adammotyl22-creator/STPPE-Reborn/pcb-layout-concept/perfboard-cutting-plan.png

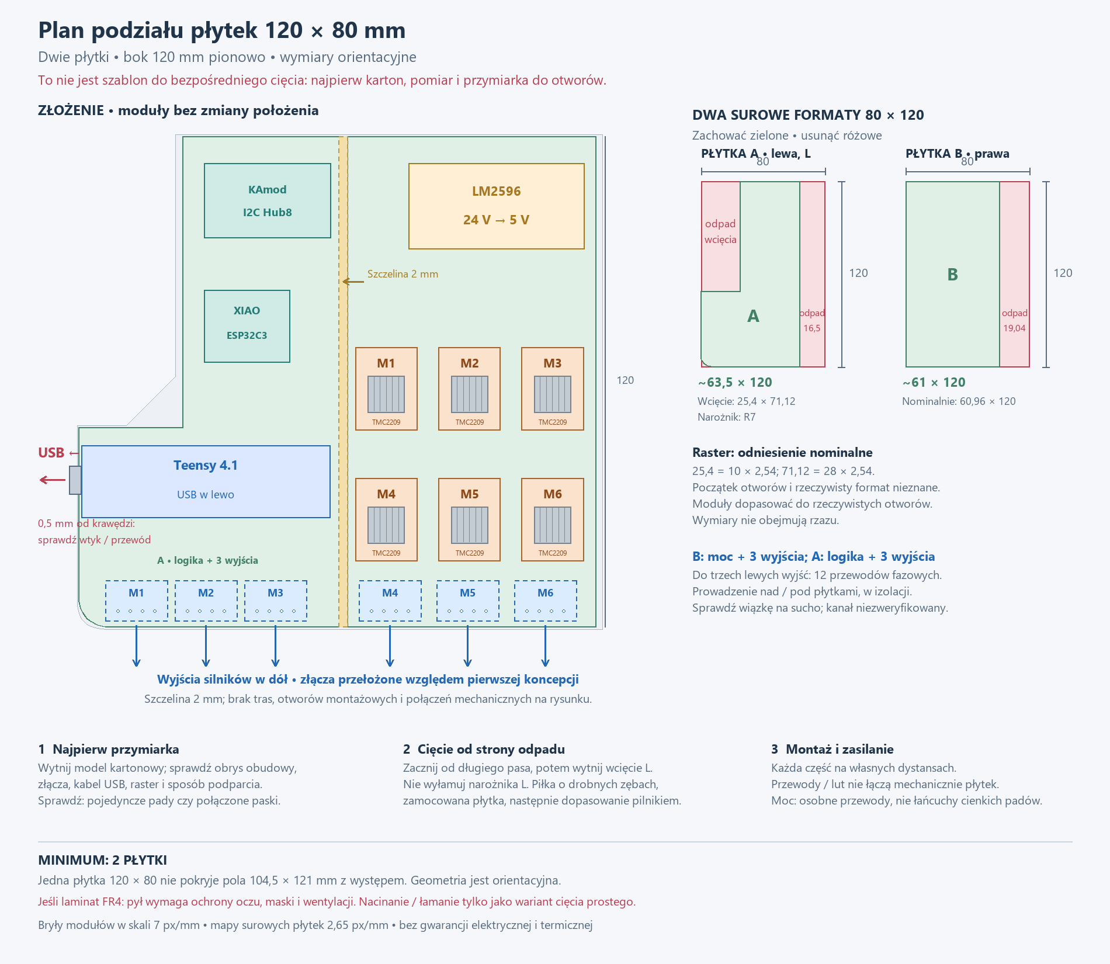
pcb-layout-concept/perfboard-cutting-plan.png
