adammotyl22-creator/STPPE-Reborn/pcb-layout-concept/robot-pcb-layout.png

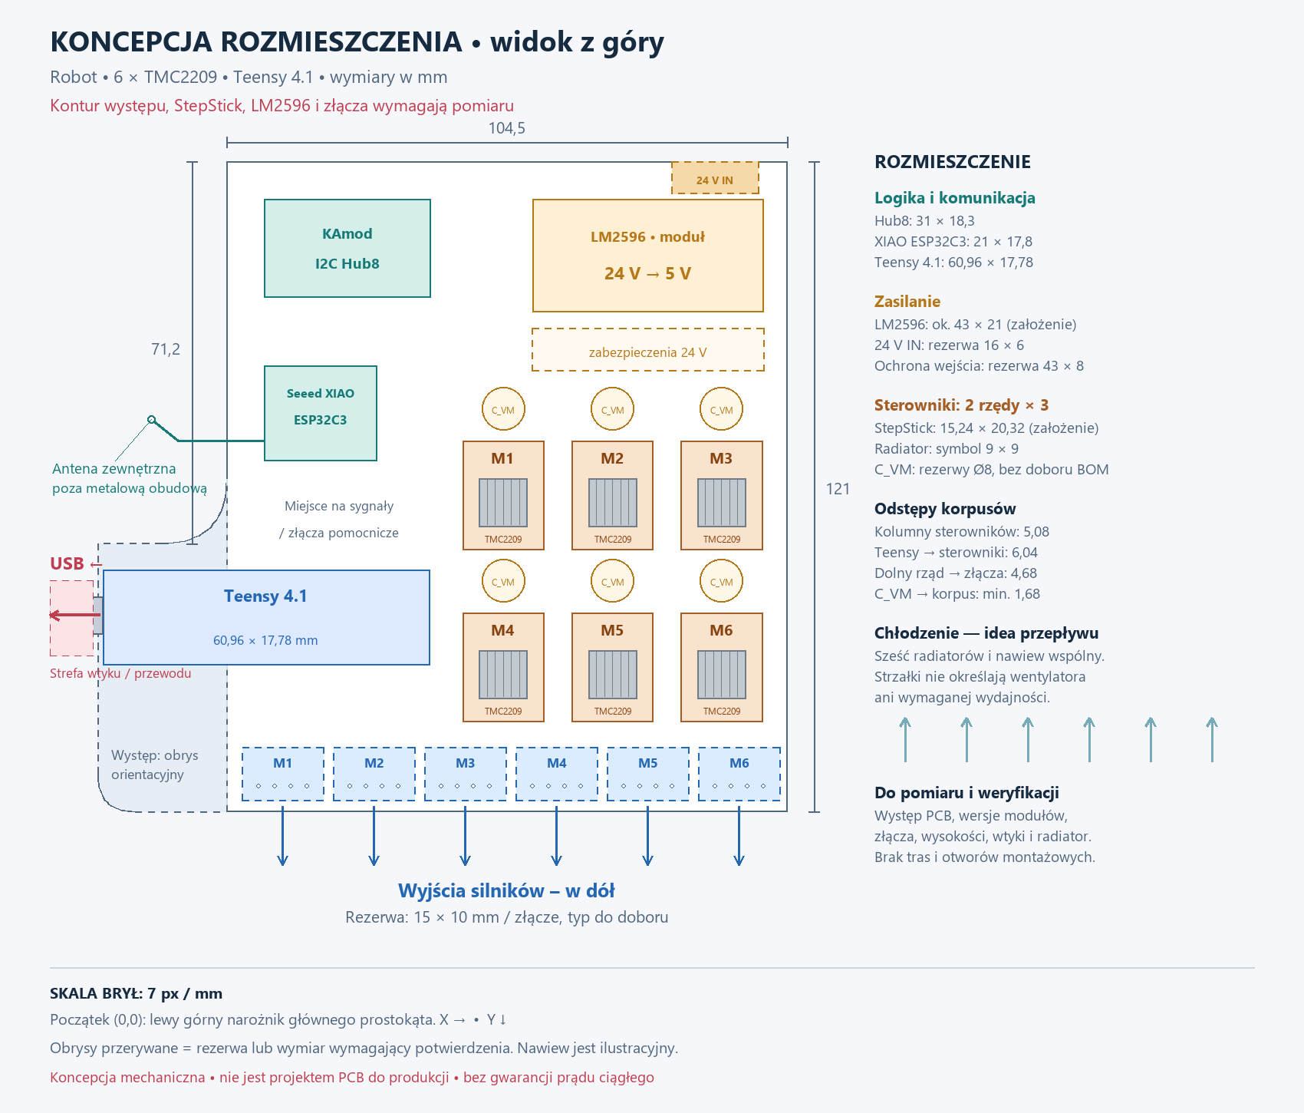
pcb-layout-concept/robot-pcb-layout.png
