adammotyl22-creator/STPPE-Reborn/WebControl/meshes/link_3.stl

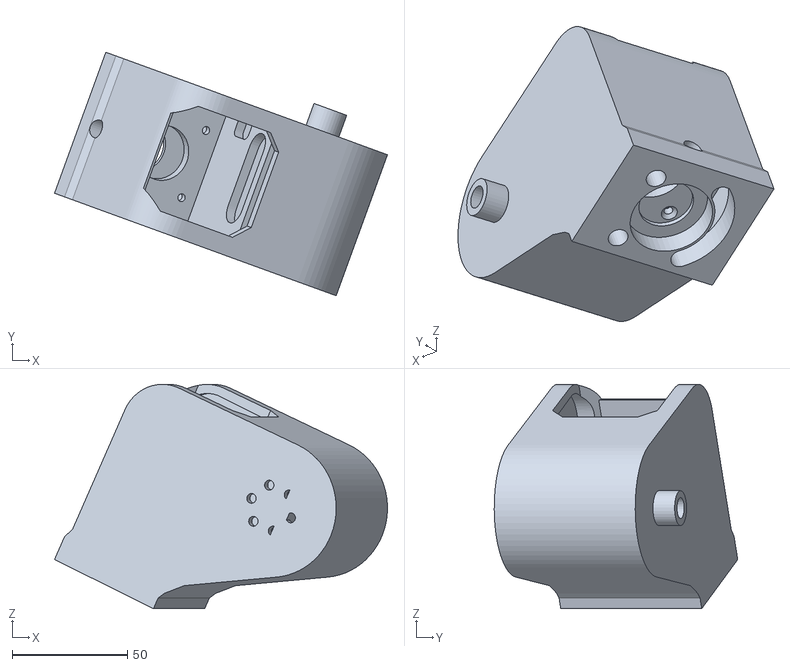
[picture p5: CAD file, 2026-10-12]
WebControl/meshes/link_3.stl
144.3 x 105.5 x 97.1
