adammotyl22-creator/STPPE-Reborn/WebControl/meshes/link_2.stl

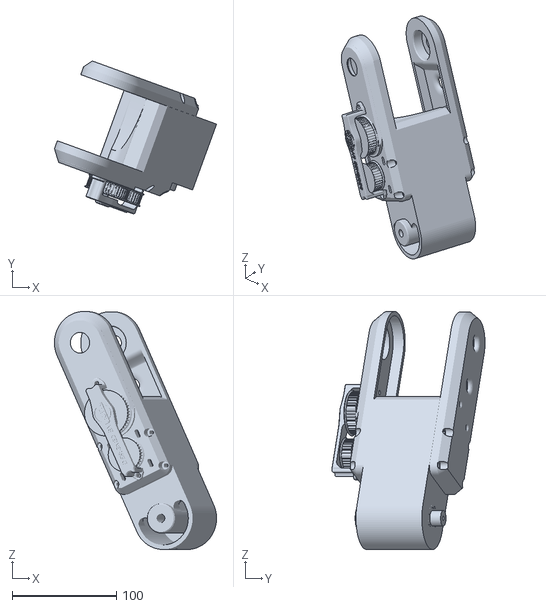
[picture p6: CAD file, 2026-10-12]
WebControl/meshes/link_2.stl
155.7 x 147.0 x 228.6
