adammotyl22-creator/STPPE-Reborn/WebControl/meshes/link_4.stl

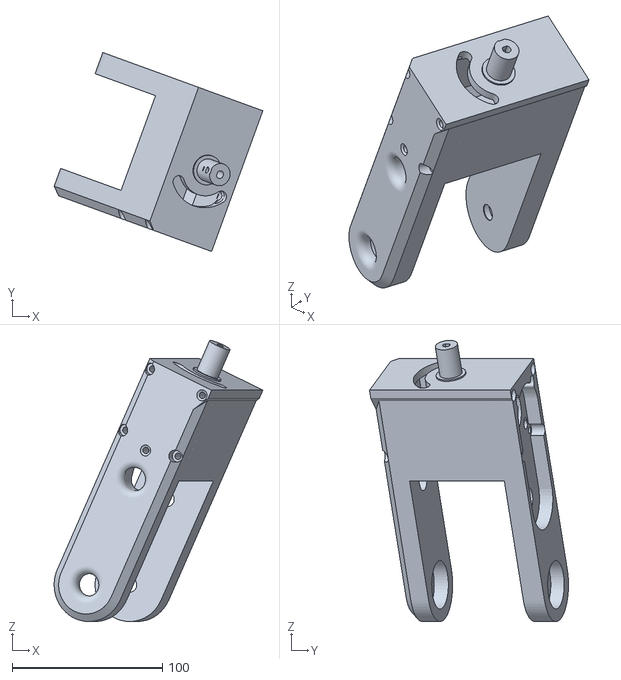
[picture p7: CAD file, 2026-10-12]
WebControl/meshes/link_4.stl
139.1 x 132.6 x 187.3
