adammotyl22-creator/STPPE-Reborn/WebControl/meshes/base_link.stl

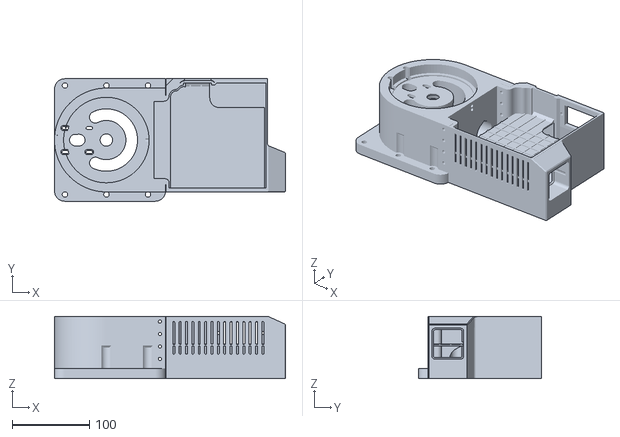
[picture p8: CAD file, 2026-10-12]
WebControl/meshes/base_link.stl
298.1 x 158.1 x 80.4
