adammotyl22-creator/STPPE-Reborn/WebControl/meshes/link_5.stl

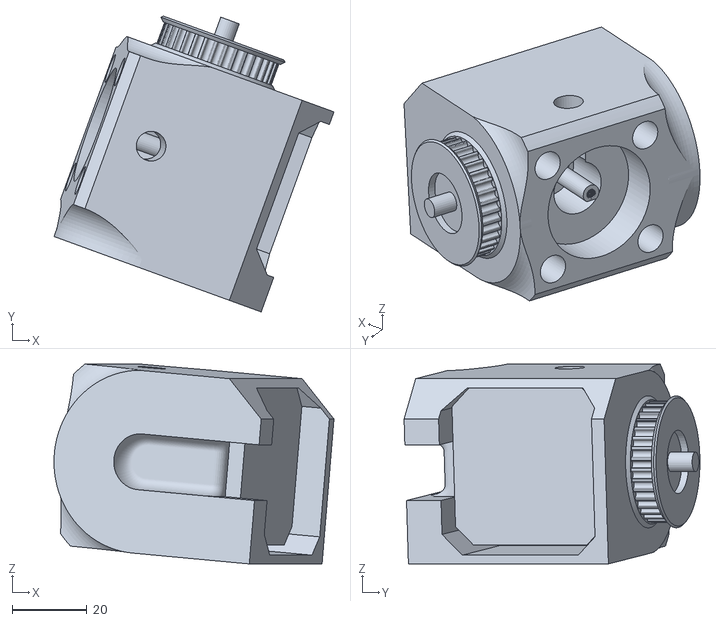
[picture p9: CAD file, 2026-10-12]
WebControl/meshes/link_5.stl
75.1 x 79.4 x 53.6
