adammotyl22-creator/STPPE-Reborn/WebControl/meshes/link_6.stl

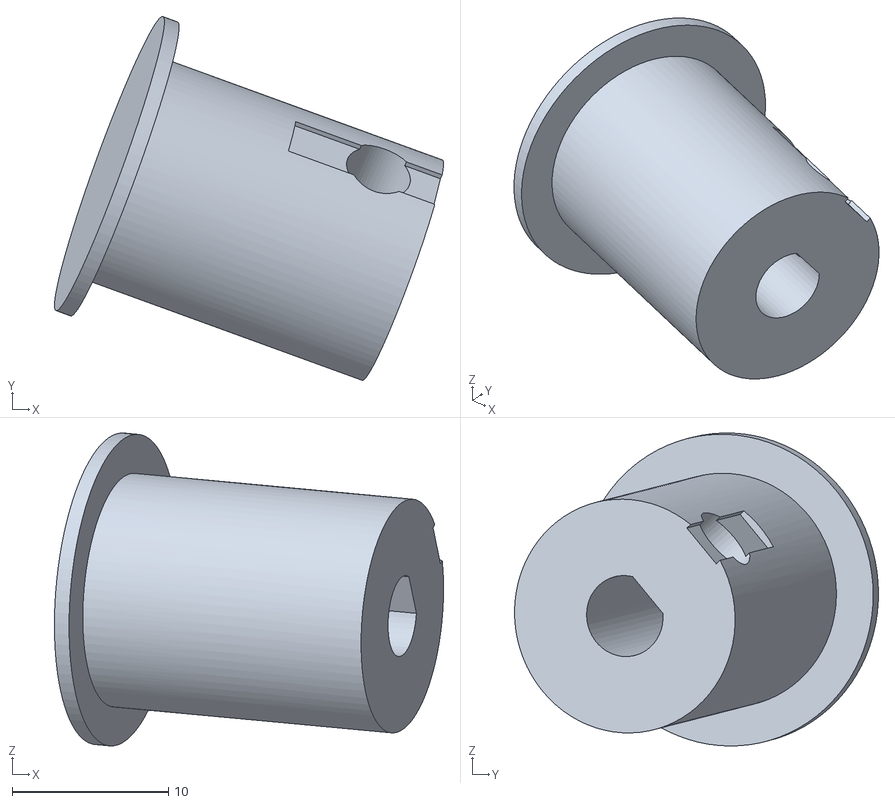
[picture p10: CAD file, 2026-10-12]
WebControl/meshes/link_6.stl
24.9 x 23.3 x 20.0
