adammotyl22-creator/STPPE-Reborn/WebControl/meshes/link_1.stl

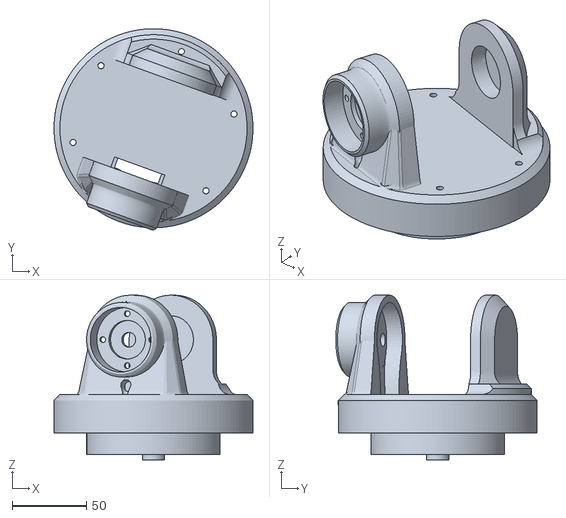
[picture p11: CAD file, 2026-10-12]
WebControl/meshes/link_1.stl
134.0 x 135.7 x 110.9
