adammotyl22-creator/STPPE-Reborn/pcb-layout-concept/motor-wiring-layout.png

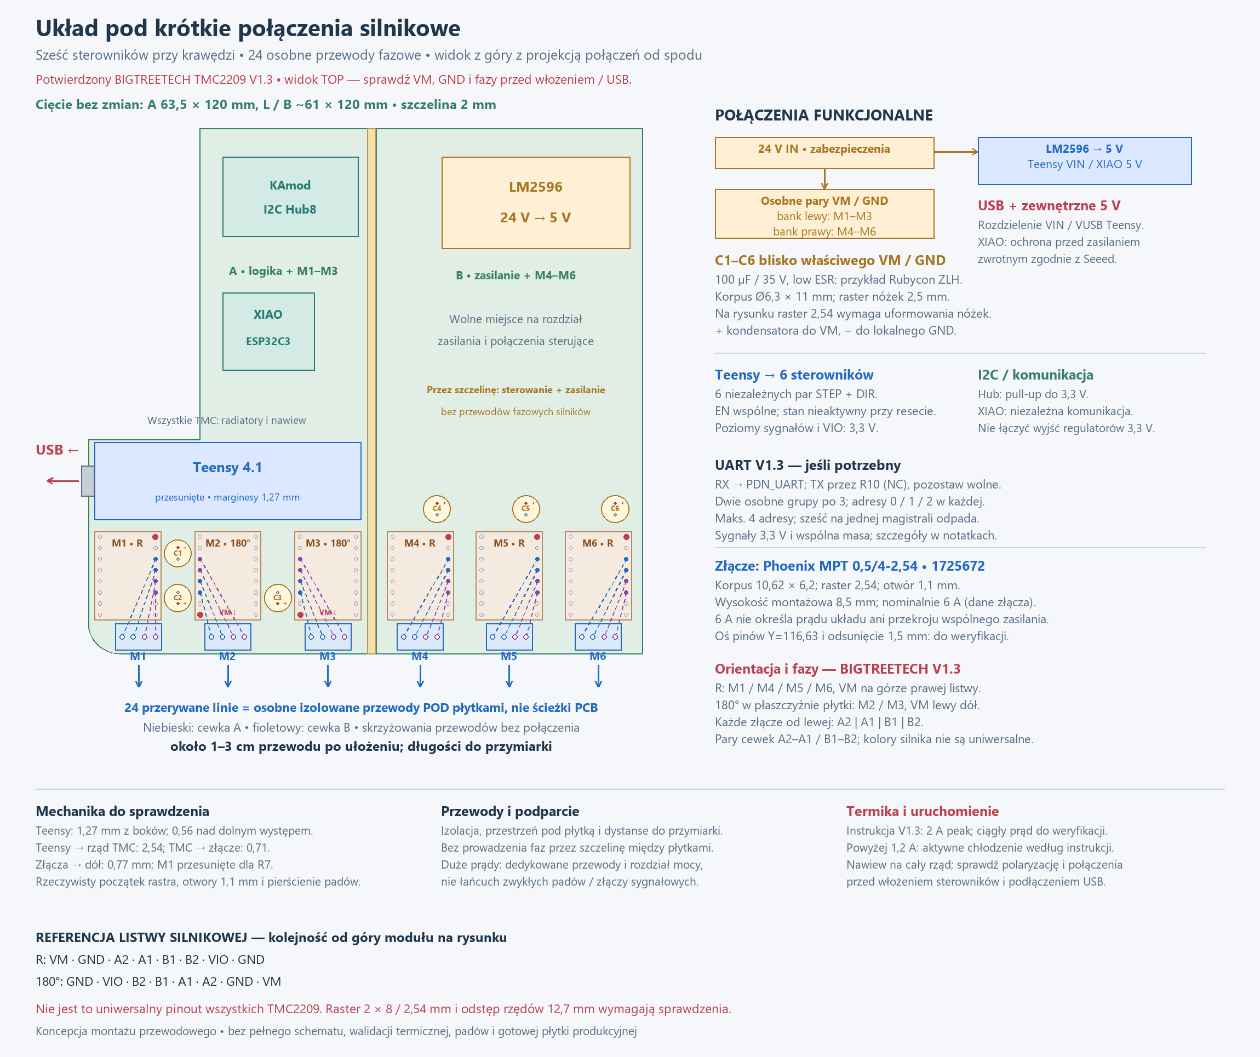
pcb-layout-concept/motor-wiring-layout.png
