adammotyl22-creator/STPPE-Reborn/Firmware/Teensy_4.1/IK_Control/IK_Control.ino

/*
 * IK Control - Inverse Kinematics + Full Hardware + USB Host
 * - Robot: stppe_zlozenie_nowe (6-DOF + Gripper)
 * - 6x Main Arm Steppers J1-J6 (TMC2209)
 * - 1x Gripper Servo (Pin 21)
 * - 3x AS5600 Encoders
 * - USB Host (Master Gesture Controller)
 * - Non-Blocking Homing State Machine
 * - Analytical IK Solver
 * - Cartesian Linear Path (MOVL)
 * - Teach & Playback Mode
 * - JSON Telemetry Stream
 * - Tool / Work Frame Offsets
 * - Watchdog Timer
 *
 * ROBOT DIMENSIONS (URDF stppe_zlozenie_nowe):
 * - Base Height (BASE_H): 143.896 mm
 * - Link 1 (Shoulder):    185.845 mm
 * - Link 2 (Forearm):     225.478 mm
 * - Link 3 (Wrist J5-J6):  36.105 mm
 * - Tool Total Length:     31.530 mm
 */

#include <AccelStepper.h>
#include <Arduino.h>
#include <EEPROM.h>
#include <IntervalTimer.h>
#include <Servo.h>
#include <TMCStepper.h>
#include <USBHost_t36.h>
#include <Watchdog_t4.h>
#include <Wire.h>
#include <math.h>

struct SplinePoint { float j1, j2, j3, j4, j5, j6; };
struct Quat { float w, x, y, z; };  // Unit quaternion (used by movL6DOF SLERP)
struct Waypoint;
enum class WristMode : uint8_t {
  LEVEL     = 0,   // tool poziomo (pick & place z boku)
  DOWN_0    = 1,   // tool pionowo w dół, J5=90°  (pick z góry, prosto)
  DOWN_90   = 2,   // tool pionowo w dół, J5=180° (pick z góry, obrócony)
  PITCH_0   = 3,   // pitch=0°,   J5 z parametru
  PITCH_90  = 4,   // pitch=90°,  J5 z parametru
  PITCH_180 = 5,   // pitch=180°, J5 z parametru
  MANUAL    = 6    // J4 i J5 podane ręcznie
};
enum class OpMode : uint8_t { T1_MANUAL_REDUCED = 0, AUTO = 1 };
volatile OpMode currentOpMode = OpMode::AUTO;
volatile bool controlledStopReq = false;
volatile float rampScale = 1.0f;
struct CubicCoeffs { float c0, c1, c2, c3, c4, c5; };
struct MotionTrajectory {
  CubicCoeffs coeffJ1;
  CubicCoeffs coeffJ2;
  CubicCoeffs coeffJ3;
  CubicCoeffs coeffJ4;
  CubicCoeffs coeffJ5;
  CubicCoeffs coeffJ6;
  float durationUs;
  float duration_s;
};
// REFACTOR: const& zamiast kopii przez wartość — eliminuje kopiowanie ~40B na stos przy każdym wywołaniu
SplinePoint calcTangent(const SplinePoint& prev, const SplinePoint& next);
bool solveCubicHermite(float p0, float p1, float v0, float v1, float duration_s, CubicCoeffs &coeff, float a0 = 0.0f, float a1 = 0.0f);
void evaluateCubic(const CubicCoeffs &coeff, float t, float &pos, float &vel, float &acc);
void buildActiveCubicCoeffs(const SplinePoint &p0, const SplinePoint &p1, const SplinePoint &v0, const SplinePoint &v1, float duration_s, const SplinePoint &a0, const SplinePoint &a1);
void blendActiveSpline(const Waypoint &wpTarget);
void applyHoldCurrent();
void applyRunCurrent();
void applySpeedOverride();

// Shortest-path angle wrapping helper: maps delta to [-180, +180) deg
static inline float wrapAngleDeltaDeg(float delta) {
  delta = fmodf(delta + 180.0f, 360.0f);
  if (delta < 0.0f) delta += 360.0f;
  return delta - 180.0f;
}

const char *FIRMWARE_VERSION = "v3.3.0";
const char *BUILD_DATE = __DATE__;
const char *BUILD_TIME = __TIME__;

// ─── Watchdog ────────────────────────────────────────────────────────────────
WDT_T4<WDT1> watchdog;
IntervalTimer motionTimer;
IntervalTimer stepTimer;

volatile bool isHomed = false;
volatile bool motionLoopActive = false;
volatile float motionTargetPos1 = 0.0f;
volatile float motionTargetPos2 = 0.0f;
volatile float motionTargetPos3 = 0.0f;
volatile float motionTargetPos4 = 0.0f;
volatile float motionTargetPos5 = 0.0f;
volatile float motionTargetPos6 = 0.0f;
volatile float motionTargetSpeed1 = 0.0f;
volatile float motionTargetSpeed2 = 0.0f;
volatile float motionTargetSpeed3 = 0.0f;
volatile float motionTargetSpeed4 = 0.0f;
volatile float motionTargetSpeed5 = 0.0f;
volatile float motionTargetSpeed6 = 0.0f;
#define motionTargetServo4 motionTargetPos4
#define motionTargetServo5 motionTargetPos5
#define motionTargetServo6 motionTargetPos6
volatile float motionLoopDtUs = 0.0f;
constexpr float STEP_ISR_FREQ_HZ = 1000000.0f / 30.0f;
volatile int32_t ddaPhaseAcc[6] = {0x8000, 0x8000, 0x8000, 0x8000, 0x8000, 0x8000};
volatile int32_t ddaPhaseInc[6] = {0, 0, 0, 0, 0, 0};
volatile float cachedEncAngle1 = 0.0f;
volatile float cachedEncAngle2 = 0.0f;
volatile float cachedEncAngle3 = 0.0f;
volatile bool cachedEncoderValid = false;

void motionLoopISR();
void stepLoopISR();
void startSegmentFromQueue();
void refreshEncoderCache();

// ================= USB HOST SETUP =================
USBHost myusb;
USBHub hub1(myusb);
USBSerial userial(myusb); // Serial from handheld controller

// ================= PIN DEFINITIONS =================
// Axis 1 (Main Base)
const int PIN_AXIS1_STEP = 3;
const int PIN_AXIS1_DIR = 2;
const int PIN_AXIS1_EN = 6;

// Axis 2 (Shoulder)
const int PIN_AXIS2_STEP = 11;
const int PIN_AXIS2_DIR = 10;
const int PIN_AXIS2_EN = 27;

// Axis 3 (Elbow)
const int PIN_AXIS3_STEP = 29;
const int PIN_AXIS3_DIR = 28;
const int PIN_AXIS3_EN = 32;

// Axis 4, 5, 6 Stepper Drivers (TMC2209)
const int PIN_AXIS4_STEP = 34;
const int PIN_AXIS4_DIR = 33;
const int PIN_AXIS5_STEP = 31;
const int PIN_AXIS5_DIR = 30;
const int PIN_AXIS6_STEP = 23;
const int PIN_AXIS6_DIR = 22;
const int PIN_WRIST_EN = 12;

// Compatibility aliases for legacy pin symbols
const int PIN_MICRO_X_STEP = 34;
const int PIN_MICRO_X_DIR = 33;
const int PIN_MICRO_Y_STEP = 31;
const int PIN_MICRO_Y_DIR = 30;
const int PIN_MICRO_EN = 12;
const int PIN_MICRO_X_LIMIT = 7;
const int PIN_MICRO_Y_LIMIT = 8;

// Gripper servo (Axis 6)
const int PIN_GRIPPER_SERVO = 21;

// ── Limit switch pins (wire your physical switches here) ──────────────────
const int PIN_J1_LIMIT = 5;
const int PIN_J2_LIMIT = 4;
const int PIN_J3_LIMIT = 36;

// ── EEPROM memory map ─────────────────────────────────────────────────────
#define EEPROM_MAGIC_ADDR       0    // 4 bytes
#define EEPROM_GEAR1_ADDR       4    // 4 bytes float
#define EEPROM_GEAR2_ADDR       8    // 4 bytes float
#define EEPROM_JNT_EN_ADDR     12    // 3 bytes  (one per joint)
#define EEPROM_SPEED_OVR_ADDR  15    // 4 bytes float
#define EEPROM_TOOL_OFF_ADDR   19    // 12 bytes (3x float)
#define EEPROM_WORK_OFF_ADDR   31    // 12 bytes (3x float)
#define EEPROM_MAXSPD_ADDR     43    // 12 bytes (3x float) — MAX_SPEED per axis
#define EEPROM_MAXACC_ADDR     55    // 12 bytes (3x float) — MAX_ACCEL per axis
#define EEPROM_SAFETY_ADDR     67    // 4 bytes float — spline safety margin
#define EEPROM_TEACH_COUNT_ADDR 71   // 1 byte uint8_t
#define EEPROM_TEACH_DATA_ADDR  72   // MAX_TEACH_POINTS * sizeof(TeachPoint) (max 1536 bytes)
#define EEPROM_BACKLASH_ADDR  2048   // 28 bytes (magic + 6x float backlash)
#define EEPROM_MAGIC_NUMBER    0x494B3103  // "IK" + version 03 (teach points persistence)
#define BACKLASH_MAGIC         0x424C5348  // "BLSH"

// ── Backlash Compensation Configuration ───────────────────────────────────
struct BacklashConfig {
  uint32_t magic;
  float backlashDeg[6];
};
BacklashConfig backlashConfig = {
  BACKLASH_MAGIC,
  { 0.25f, 0.40f, 0.40f, 0.20f, 0.20f, 0.20f }
};
int8_t lastDirection[6] = { 0, 0, 0, 0, 0, 0 };
float backlashOffsetSteps[6] = { 0.0f, 0.0f, 0.0f, 0.0f, 0.0f, 0.0f };

// ── EEPROM Write Coalescing (3-second debounced dirty flag) ───────────────
bool eepromDirty = false;
unsigned long eepromDirtyTime = 0;
const unsigned long EEPROM_DEBOUNCE_MS = 3000;

inline void scheduleEepromSave() {
  eepromDirty = true;
  eepromDirtyTime = millis();
}

// ── Speed override (global multiplier 0.0–1.0) ───────────────────────────
// Marked volatile as it is read by motionLoopISR() and written in loop()
volatile float speedOverride = 1.0f;   // 1.0 = 100%, 0.5 = 50%

// (SD card support removed)

// AS5600 Encoders — Hardware I2C
// ENC1 (Base)     → Wire2: SDA=25, SCL=24
// ENC2 (Shoulder) → Wire:  SDA=18, SCL=19
// ENC3 (Elbow)    → Wire1: SDA=44, SCL=45

float enc1Offset = 0;
float enc2Offset = 0;
float enc3Offset = 0;

// Cached encoder values to prevent redundant I2C reads
uint16_t lastEnc2 = 0;
uint16_t lastEnc3 = 0;

// Shared flags with ISR context: marked volatile
volatile bool useEncoders = true; // Default: Enabled
volatile bool estopActive = false; // Track emergency stop state

// UART / TMC Configuration
#define SERIAL_PORT Serial4
#define R_SENSE 0.11f

// ================= ROBOT GEOMETRY (URDF: stppe_zlozenie_nowe) =================
#define BASE_H          143.896f   // Floor to shoulder J2 axis (mm)
#define L1              185.845f   // Shoulder J2 to elbow J3 (mm)
#define L2              225.478f   // Elbow J3 to wrist J5 (mm)
#define L2_PAR          225.478f   // Compatibility alias
#define L2_PERP           0.0f     // Compatibility alias
#define L3               36.105f   // Wrist J5 to tool flange J6 (mm)
#define TOOL_TOTAL_LEN   31.530f   // Effective radial offset from J5 to TCP (mm)
#define TH1_0           (25.0097f * DEG_TO_RAD)
#define TH2_0           (140.4962f * DEG_TO_RAD)
#define REL_0           (TH2_0 - TH1_0)
#define GAMMA_0         (PI - REL_0)
#define TOOL_REST_ANGLE (4.896f * DEG_TO_RAD)
#define EXCL_R2         6400.0f    // r < 80mm exclusion zone (80² = 6400)
#define FLOOR_CLR         20.0f    // min clearance above floor (mm)

// ================= SAFETY LIMITS (URDF: stppe_zlozenie_nowe) =================
const float LIMIT_J1_MIN = -90.0f, LIMIT_J1_MAX =  90.0f;
const float LIMIT_J2_MIN = -65.0f, LIMIT_J2_MAX = 115.0f;
const float LIMIT_J3_MIN = -35.0f, LIMIT_J3_MAX = 170.0f;
const float LIMIT_J4_MIN = -90.0f, LIMIT_J4_MAX =  90.0f;
const float LIMIT_J5_MIN = -120.0f, LIMIT_J5_MAX = 120.0f;
const float LIMIT_J6_MIN = -180.0f, LIMIT_J6_MAX = 180.0f;

// Commanded Positions (Closed Loop Targets)
volatile float commandedAngle1 = 0;
volatile float commandedAngle2 = 0;
volatile float commandedAngle3 = 0;
volatile float commandedAngle4 = 0;
volatile float commandedAngle5 = 0;
volatile float commandedAngle6 = 0;

// ================= MOTION SETTINGS =================
const int STEPS_PER_REV = 200;
const int MICROSTEPS = 16;
const float STEPS_PER_MOTOR_REV = STEPS_PER_REV * MICROSTEPS; // 3200

// Main Arm Gearing
float gearboxRatioAxis1 = 8.33;
float stepsPerDegAxis1 = (STEPS_PER_MOTOR_REV * gearboxRatioAxis1) / 360.0; // ~74.05

float gearboxRatio = 20.0;
float stepsPerDegGeared = (STEPS_PER_MOTOR_REV * gearboxRatio) / 360.0; // ~177.78

// Wrist Gearing & Microsteps
float gearboxRatioAxis4 = 1.0f;
float gearboxRatioAxis5 = 1.0f;
float gearboxRatioAxis6 = 1.0f;
float stepsPerDegAxis4 = (STEPS_PER_MOTOR_REV * gearboxRatioAxis4) / 360.0f; // ~8.889
float stepsPerDegAxis5 = (STEPS_PER_MOTOR_REV * gearboxRatioAxis5) / 360.0f;
float stepsPerDegAxis6 = (STEPS_PER_MOTOR_REV * gearboxRatioAxis6) / 360.0f;

// ─── CALIBRATION: Adjust these to find your hardware's sweet spot ────────
// Maximum motor speed in steps/second per axis.
// Start LOW and increase until steps are lost, then back off 20%.
// Halved from previous values (40k/80k/60k) which caused step loss.
float MAX_SPEED_J1 = 10000.0f;   // Base   — was 40000
float MAX_SPEED_J2 = 25000.0f;   // Shoulder — was 80000 (main culprit)
float MAX_SPEED_J3 = 10000.0f;   // Elbow — was 60000
float MAX_SPEED_J4 = 10000.0f;   // Forearm Roll
float MAX_SPEED_J5 = 10000.0f;   // Wrist Pitch
float MAX_SPEED_J6 = 10000.0f;   // Tool Flange Roll

// Maximum acceleration in steps/s² per axis (prevents sudden speed jumps)
float MAX_ACCEL_J1 = 15000.0f;
float MAX_ACCEL_J2 = 25000.0f;
float MAX_ACCEL_J3 = 20000.0f;
float MAX_ACCEL_J4 = 20000.0f;
float MAX_ACCEL_J5 = 20000.0f;
float MAX_ACCEL_J6 = 20000.0f;

// Jerk limit in steps/s³. High bandwidth for clean quintic spline tracking.
float MAX_JERK_J1 = MAX_ACCEL_J1 * 20.0f;
float MAX_JERK_J2 = MAX_ACCEL_J2 * 20.0f;
float MAX_JERK_J3 = MAX_ACCEL_J3 * 20.0f;
float MAX_JERK_J4 = MAX_ACCEL_J4 * 20.0f;
float MAX_JERK_J5 = MAX_ACCEL_J5 * 20.0f;
float MAX_JERK_J6 = MAX_ACCEL_J6 * 20.0f;

// Rest-to-rest quintic peak velocity is 1.875 times average velocity.
float SPLINE_SAFETY_MARGIN = 1.88f;

// Rate-limiter state (used in velocity-mode update)
float lastSpdJ1 = 0.0f, lastSpdJ2 = 0.0f, lastSpdJ3 = 0.0f;
float lastSpdJ4 = 0.0f, lastSpdJ5 = 0.0f, lastSpdJ6 = 0.0f;
float lastAccJ1 = 0.0f, lastAccJ2 = 0.0f, lastAccJ3 = 0.0f;
float lastAccJ4 = 0.0f, lastAccJ5 = 0.0f, lastAccJ6 = 0.0f;

static constexpr float CAL_ENC_NO_DATA = -1.0f;

// Calibration test state
bool calTestActive = false;
volatile bool calTestDone = false;
float calTestStartEnc1 = CAL_ENC_NO_DATA;
float calTestStartEnc2 = CAL_ENC_NO_DATA;
float calTestStartEnc3 = CAL_ENC_NO_DATA;

// J3 (elbow) is mechanically inverted versus IK positive angle convention.
const float J3_STEP_SIGN = -1.0f;
inline long j3AngleToSteps(float deg) { return (long)roundf(deg * stepsPerDegGeared * J3_STEP_SIGN); }
inline float j3StepsToAngle(long steps) { return (float)steps / (stepsPerDegGeared * J3_STEP_SIGN); }

inline long j4AngleToSteps(float deg) { return (long)roundf(deg * stepsPerDegAxis4); }
inline float j4StepsToAngle(long steps) { return (float)steps / stepsPerDegAxis4; }
inline long j5AngleToSteps(float deg) { return (long)roundf(deg * stepsPerDegAxis5); }
inline float j5StepsToAngle(long steps) { return (float)steps / stepsPerDegAxis5; }
inline long j6AngleToSteps(float deg) { return (long)roundf(deg * stepsPerDegAxis6); }
inline float j6StepsToAngle(long steps) { return (float)steps / stepsPerDegAxis6; }

float getStepsPerDeg(uint8_t axisIdx) {
  switch (axisIdx) {
    case 0: return stepsPerDegAxis1;
    case 1: return stepsPerDegGeared;
    case 2: return stepsPerDegGeared * fabsf(J3_STEP_SIGN);
    case 3: return stepsPerDegAxis4;
    case 4: return stepsPerDegAxis5;
    case 5: return stepsPerDegAxis6;
    default: return 1.0f;
  }
}

float applyBacklashComp(uint8_t axisIdx, float deltaDeg) {
  if (axisIdx >= 6) return 0.0f;
  if (fabsf(deltaDeg) > 0.005f) {
    int8_t dir = (deltaDeg > 0.0f) ? 1 : -1;
    if (dir != lastDirection[axisIdx]) {
      float blSteps = backlashConfig.backlashDeg[axisIdx] * getStepsPerDeg(axisIdx);
      if (dir > 0) {
        backlashOffsetSteps[axisIdx] = 0.0f;
      } else {
        backlashOffsetSteps[axisIdx] = (axisIdx == 2 && J3_STEP_SIGN < 0) ? blSteps : -blSteps;
      }
      lastDirection[axisIdx] = dir;
    }
  }
  return backlashOffsetSteps[axisIdx];
}

// ================= OBJECTS =================
TMC2209Stepper driver1(&SERIAL_PORT, R_SENSE, 0b00); // Address 0
TMC2209Stepper driver2(&SERIAL_PORT, R_SENSE, 0b10); // Address 2
TMC2209Stepper driver3(&SERIAL_PORT, R_SENSE, 0b01); // Address 1

AccelStepper stepper1(AccelStepper::DRIVER, PIN_AXIS1_STEP, PIN_AXIS1_DIR);
AccelStepper stepper2(AccelStepper::DRIVER, PIN_AXIS2_STEP, PIN_AXIS2_DIR);
AccelStepper stepper3(AccelStepper::DRIVER, PIN_AXIS3_STEP, PIN_AXIS3_DIR);
AccelStepper stepper4(AccelStepper::DRIVER, PIN_AXIS4_STEP, PIN_AXIS4_DIR);
AccelStepper stepper5(AccelStepper::DRIVER, PIN_AXIS5_STEP, PIN_AXIS5_DIR);
AccelStepper stepper6(AccelStepper::DRIVER, PIN_AXIS6_STEP, PIN_AXIS6_DIR);

inline void setStepperSpeedDDA(uint8_t idx, AccelStepper &s, float stepsPerSec) {
  (void)s;
  ddaPhaseInc[idx] = (stepsPerSec == 0.0f)
      ? 0 : (int32_t)roundf(stepsPerSec * (65536.0f / STEP_ISR_FREQ_HZ));
}

#define stepperX stepper4
#define stepperY stepper5

Servo gripper;
float gripperAngle = 90.0f;

// Buffers (Fixed 128 bytes)
char inputBuffer[128];
uint8_t inputBufferPos = 0;
char usbBuffer[128];
uint8_t usbBufferPos = 0;
char espBuffer[128];
uint8_t espBufferPos = 0;

// PID Controller Structure
struct PIDController {
  float kP, kI, kD, kFF, kG;
  float integral = 0;
  float lastError = 0;
  float maxIntegral = 5.0f;  // Anti-windup limit: prevents excessive integral accumulation
  float deadband = 0.35f;    // Calibrated deadband (0.35°) prevents sensor noise jitter and motor hunting

  // Initialize with specific gains
  void init(float p, float i, float d, float ff, float g = 0.0f) {
    kP = p; kI = i; kD = d; kFF = ff; kG = g;
    integral = 0;
    lastError = 0;
  }

  float calculate(float error, float dt, float targetVelocity) {
    // Deadband: within 0.35°, zero adjustment to avoid hunting around target
    if (fabsf(error) < deadband) {
      integral = 0;
      return 0.0f;
    }

    integral += error * dt;
    integral = constrain(integral, -maxIntegral, maxIntegral);

    float derivative = (dt > 0.0f) ? (error - lastError) / dt : 0.0f;
    lastError = error;

    float output = (kP * error) + (kI * integral) + (kD * derivative);
    return constrain(output, -1.2f, 1.2f); // Clamp max adjustment to ±1.2° to prevent twitching
  }
};

PIDController pid1, pid2, pid3;

// Closed Loop Adjustments (written by ISR in updateClosedLoop, read in loop)
volatile float pidAdj1 = 0.0f;
volatile float pidAdj2 = 0.0f;
volatile float pidAdj3 = 0.0f;

// Timing Constants
const unsigned long MAX_INPUT_TIME_US = 15000;
const unsigned long MAX_LOOP_TIME_US = 10000;
const uint8_t MAX_ENCODER_FAILURES = 10;

// State Flags
bool manualCL = false; // Set by CL_ON: suppress auto-disable on encoder errors
bool encEnabled[3] = {false, true, true};
bool jointEnabled[6] = {true, true, true, true, true, true};
bool useTelemetry = false;    // 10Hz position stream (AR4 format)
bool useJsonTelemetry = false; // 10Hz JSON stream for dashboard

// ── Collision detection ──────────────────────────────────────────────────
// Calibrated to 1.8°: provides ample margin above AS5600 12-bit encoder resolution (0.088°/LSB)
// and 20:1 planetary/cycloidal gearbox backlash (0.3°–0.8° on direction reversal),
// while reliably catching genuine stalls or physical obstructions without false trips.
#define COLLISION_THRESH_DEG  1.8f
int  J1collisionTrue = 0;
int  J2collisionTrue = 0;
int  J3collisionTrue = 0;

// ── Hold current state ───────────────────────────────────────────────────
bool holdCurrentActive = false;

// ── Waypoint queue ───────────────────────────────────────────────────────
struct Waypoint {
  float j1, j2, j3, j4, j5, j6;
  unsigned long duration_ms;
};

const uint8_t WAYPOINT_QUEUE_SIZE = 32;  // supports a 16+ waypoint look-ahead buffer
const uint8_t LOOKAHEAD_WAYPOINTS = 16;
Waypoint motionQueue[WAYPOINT_QUEUE_SIZE];
volatile uint8_t qHead = 0;
volatile uint8_t qTail = 0;
volatile bool isMovingQueue = false;

// ── Spline Interpolation State ───────────────────────────────────────────
volatile float splineT = 0.0f;
volatile unsigned long lastSplineTime = 0; // stored in microseconds!
volatile float splineDuration = 0.0f;      // stored in microseconds!
SplinePoint sp1, sp2, sv1, sv2, sa1, sa2;
SplinePoint spPrev;
volatile bool wasContinuous = false;
CubicCoeffs cubicCoeffJ1, cubicCoeffJ2, cubicCoeffJ3, cubicCoeffJ4, cubicCoeffJ5, cubicCoeffJ6;
MotionTrajectory activeTrajectory;
volatile float currentVelJ1 = 0.0f, currentVelJ2 = 0.0f, currentVelJ3 = 0.0f, currentVelJ4 = 0.0f, currentVelJ5 = 0.0f, currentVelJ6 = 0.0f;
volatile float currentAccJ1 = 0.0f, currentAccJ2 = 0.0f, currentAccJ3 = 0.0f, currentAccJ4 = 0.0f, currentAccJ5 = 0.0f, currentAccJ6 = 0.0f;
volatile float activeSegmentDuration_s = 0.001f;

// ── Slider / Joystick Streaming Target ────────────────────────────────
// When slider commands arrive rapidly, we skip the spline queue and
// directly set a live target for AccelStepper to chase.
bool   streamMode       = false;
float  streamTargetJ1   = 0.0f;
float  streamTargetJ2   = 0.0f;
float  streamTargetJ3   = 0.0f;
float  streamTargetJ4   = 0.0f;
float  streamTargetJ5   = 0.0f;
float  streamTargetJ6   = 0.0f;
float  streamVelJ1      = 0.0f;
float  streamVelJ2      = 0.0f;
float  streamVelJ3      = 0.0f;
float  streamVelJ4      = 0.0f;
float  streamVelJ5      = 0.0f;
float  streamVelJ6      = 0.0f;
unsigned long streamLastUpdateMs = 0;
unsigned long lastStreamMicros = 0;
const unsigned long STREAM_TIMEOUT_MS = 450; // ms without update → back to hold (tolerant to 80ms wireless packets)

void stopStreamMode(bool snapToTarget = true) {
  noInterrupts();
  if (snapToTarget) {
    commandedAngle1 = streamTargetJ1;
    commandedAngle2 = streamTargetJ2;
    commandedAngle3 = streamTargetJ3;
    commandedAngle4 = streamTargetJ4;
    commandedAngle5 = streamTargetJ5;
    commandedAngle6 = streamTargetJ6;
  }

  streamMode = false;
  isMovingQueue = false;
  wasContinuous = false;
  motionLoopActive = false;
  streamVelJ1 = 0.0f;
  streamVelJ2 = 0.0f;
  streamVelJ3 = 0.0f;
  streamVelJ4 = 0.0f;
  streamVelJ5 = 0.0f;
  streamVelJ6 = 0.0f;
  lastStreamMicros = 0;
  // Clear rate limiter and state trackers so subsequent moves start cleanly from rest
  lastSpdJ1 = 0.0f;
  lastSpdJ2 = 0.0f;
  lastSpdJ3 = 0.0f;
  lastSpdJ4 = 0.0f;
  lastSpdJ5 = 0.0f;
  lastSpdJ6 = 0.0f;
  lastAccJ1 = 0.0f;
  lastAccJ2 = 0.0f;
  lastAccJ3 = 0.0f;
  lastAccJ4 = 0.0f;
  lastAccJ5 = 0.0f;
  lastAccJ6 = 0.0f;
  currentVelJ1 = 0.0f;
  currentVelJ2 = 0.0f;
  currentVelJ3 = 0.0f;
  currentVelJ4 = 0.0f;
  currentVelJ5 = 0.0f;
  currentVelJ6 = 0.0f;
  currentAccJ1 = 0.0f;
  currentAccJ2 = 0.0f;
  currentAccJ3 = 0.0f;
  currentAccJ4 = 0.0f;
  currentAccJ5 = 0.0f;
  currentAccJ6 = 0.0f;
  motionTargetSpeed1 = 0.0f;
  motionTargetSpeed2 = 0.0f;
  motionTargetSpeed3 = 0.0f;
  motionTargetSpeed4 = 0.0f;
  motionTargetSpeed5 = 0.0f;
  motionTargetSpeed6 = 0.0f;

  setStepperSpeedDDA(0, stepper1, 0.0f);
  setStepperSpeedDDA(1, stepper2, 0.0f);
  setStepperSpeedDDA(2, stepper3, 0.0f);
  setStepperSpeedDDA(3, stepper4, 0.0f);
  setStepperSpeedDDA(4, stepper5, 0.0f);
  setStepperSpeedDDA(5, stepper6, 0.0f);

  stepper1.moveTo((long)roundf(commandedAngle1 * stepsPerDegAxis1) + (long)backlashOffsetSteps[0]);
  stepper2.moveTo((long)roundf(commandedAngle2 * stepsPerDegGeared) + (long)backlashOffsetSteps[1]);
  stepper3.moveTo(j3AngleToSteps(commandedAngle3) + (long)backlashOffsetSteps[2]);
  stepper4.moveTo(j4AngleToSteps(commandedAngle4) + (long)backlashOffsetSteps[3]);
  stepper5.moveTo(j5AngleToSteps(commandedAngle5) + (long)backlashOffsetSteps[4]);
  stepper6.moveTo(j6AngleToSteps(commandedAngle6) + (long)backlashOffsetSteps[5]);
  interrupts();
}

void syncCommandedToStepperPosition() {
  noInterrupts();
  commandedAngle1 = (float)(stepper1.currentPosition() - (long)backlashOffsetSteps[0]) / stepsPerDegAxis1;
  commandedAngle2 = (float)(stepper2.currentPosition() - (long)backlashOffsetSteps[1]) / stepsPerDegGeared;
  commandedAngle3 = j3StepsToAngle(stepper3.currentPosition() - (long)backlashOffsetSteps[2]);
  commandedAngle4 = j4StepsToAngle(stepper4.currentPosition() - (long)backlashOffsetSteps[3]);
  commandedAngle5 = j5StepsToAngle(stepper5.currentPosition() - (long)backlashOffsetSteps[4]);
  commandedAngle6 = j6StepsToAngle(stepper6.currentPosition() - (long)backlashOffsetSteps[5]);

  streamTargetJ1 = commandedAngle1;
  streamTargetJ2 = commandedAngle2;
  streamTargetJ3 = commandedAngle3;
  streamTargetJ4 = commandedAngle4;
  streamTargetJ5 = commandedAngle5;
  streamTargetJ6 = commandedAngle6;

  stepper1.moveTo(stepper1.currentPosition());
  stepper2.moveTo(stepper2.currentPosition());
  stepper3.moveTo(stepper3.currentPosition());
  stepper4.moveTo(stepper4.currentPosition());
  stepper5.moveTo(stepper5.currentPosition());
  stepper6.moveTo(stepper6.currentPosition());
  interrupts();
}

SplinePoint calcTangent(const SplinePoint& prev, const SplinePoint& next) {
   SplinePoint v;
   v.j1 = 0.5f * (next.j1 - prev.j1);
   v.j2 = 0.5f * (next.j2 - prev.j2);
   v.j3 = 0.5f * (next.j3 - prev.j3);
   v.j4 = 0.5f * (next.j4 - prev.j4);
   v.j5 = 0.5f * (next.j5 - prev.j5);
   v.j6 = 0.5f * (next.j6 - prev.j6);
   return v;
}

bool solveCubicHermite(float p0, float p1, float v0, float v1, float duration_s, CubicCoeffs &coeff, float a0, float a1) {
  if (duration_s < 0.001f) duration_s = 0.001f;
  float T = duration_s, T2 = T * T;
  float dp = p1 - p0;
  float sv0 = v0 * T, sv1 = v1 * T;
  float sa0 = a0 * T2, sa1 = a1 * T2;

  coeff.c0 = p0;
  coeff.c1 = sv0;
  coeff.c2 = 0.5f * sa0;
  coeff.c3 = 10.0f * dp - 6.0f * sv0 - 4.0f * sv1 - 1.5f * sa0 + 0.5f * sa1;
  coeff.c4 = -15.0f * dp + 8.0f * sv0 + 7.0f * sv1 + 1.5f * sa0 - sa1;
  coeff.c5 = 6.0f * dp - 3.0f * (sv0 + sv1) - 0.5f * sa0 + 0.5f * sa1;
  return true;
}

void evaluateCubic(const CubicCoeffs &coeff, float t, float &pos, float &vel, float &acc) {
  float t2 = t * t, t3 = t2 * t, t4 = t3 * t, t5 = t4 * t;

  pos = coeff.c0 + coeff.c1 * t + coeff.c2 * t2 + coeff.c3 * t3 + coeff.c4 * t4 + coeff.c5 * t5;
  vel = coeff.c1 + 2.0f * coeff.c2 * t + 3.0f * coeff.c3 * t2 + 4.0f * coeff.c4 * t3 + 5.0f * coeff.c5 * t4;
  acc = 2.0f * coeff.c2 + 6.0f * coeff.c3 * t + 12.0f * coeff.c4 * t2 + 20.0f * coeff.c5 * t3;
}

void buildActiveCubicCoeffs(const SplinePoint &p0, const SplinePoint &p1, const SplinePoint &v0, const SplinePoint &v1, float duration_s, const SplinePoint &a0, const SplinePoint &a1) {
  solveCubicHermite(p0.j1, p1.j1, v0.j1, v1.j1, duration_s, cubicCoeffJ1, a0.j1, a1.j1);
  solveCubicHermite(p0.j2, p1.j2, v0.j2, v1.j2, duration_s, cubicCoeffJ2, a0.j2, a1.j2);
  solveCubicHermite(p0.j3, p1.j3, v0.j3, v1.j3, duration_s, cubicCoeffJ3, a0.j3, a1.j3);
  solveCubicHermite(p0.j4, p1.j4, v0.j4, v1.j4, duration_s, cubicCoeffJ4, a0.j4, a1.j4);
  solveCubicHermite(p0.j5, p1.j5, v0.j5, v1.j5, duration_s, cubicCoeffJ5, a0.j5, a1.j5);
  solveCubicHermite(p0.j6, p1.j6, v0.j6, v1.j6, duration_s, cubicCoeffJ6, a0.j6, a1.j6);
}

inline void publishActiveTrajectory(const MotionTrajectory &trajectory) {
  noInterrupts();
  activeTrajectory = trajectory;
  splineDuration = trajectory.durationUs;
  activeSegmentDuration_s = trajectory.duration_s;
  interrupts();
}

static float estimateLookAheadScale(const SplinePoint &currentPos,
                                    const Waypoint &currentTarget,
                                    const Waypoint &nextTarget) {
  float vectors[2][6] = {
    { currentTarget.j1 - currentPos.j1, currentTarget.j2 - currentPos.j2, currentTarget.j3 - currentPos.j3,
      currentTarget.j4 - currentPos.j4, currentTarget.j5 - currentPos.j5, currentTarget.j6 - currentPos.j6 },
    { nextTarget.j1 - currentTarget.j1, nextTarget.j2 - currentTarget.j2, nextTarget.j3 - currentTarget.j3,
      nextTarget.j4 - currentTarget.j4, nextTarget.j5 - currentTarget.j5, nextTarget.j6 - currentTarget.j6 }
  };

  float normA = 0.0f;
  float normB = 0.0f;
  float dot = 0.0f;
  for (int i = 0; i < 6; ++i) {
    float a = vectors[0][i];
    float b = vectors[1][i];
    normA += a * a;
    normB += b * b;
    dot += a * b;
  }

  normA = sqrtf(normA);
  normB = sqrtf(normB);
  if (normA < 0.001f || normB < 0.001f) {
    return 1.0f;
  }

  float cosine = constrain(dot / (normA * normB), -1.0f, 1.0f);
  if (cosine <= 0.0f) {
    return 0.55f; // Sharp turn (>= 90 deg)
  }
  float turnAngle = acosf(cosine);
  float turnSeverity = constrain(turnAngle / (PI / 2.0f), 0.0f, 1.0f);
  return max(0.55f, 1.0f - (0.45f * turnSeverity));
}

static float planLookAheadDurationUs(const SplinePoint &currentPos,
                                     const Waypoint &currentTarget,
                                     float requestedDurationMs) {
  float delta1 = fabsf(currentTarget.j1 - currentPos.j1) * stepsPerDegAxis1;
  float delta2 = fabsf(currentTarget.j2 - currentPos.j2) * stepsPerDegGeared;
  float delta3 = fabsf(currentTarget.j3 - currentPos.j3) * stepsPerDegGeared;
  float delta4 = fabsf(currentTarget.j4 - currentPos.j4) * stepsPerDegAxis4;
  float delta5 = fabsf(currentTarget.j5 - currentPos.j5) * stepsPerDegAxis5;
  float delta6 = fabsf(currentTarget.j6 - currentPos.j6) * stepsPerDegAxis6;

  float minTime1 = (delta1 / MAX_SPEED_J1) * SPLINE_SAFETY_MARGIN * 1000000.0f;
  float minTime2 = (delta2 / MAX_SPEED_J2) * SPLINE_SAFETY_MARGIN * 1000000.0f;
  float minTime3 = (delta3 / MAX_SPEED_J3) * SPLINE_SAFETY_MARGIN * 1000000.0f;
  float minTime4 = (delta4 / MAX_SPEED_J4) * SPLINE_SAFETY_MARGIN * 1000000.0f;
  float minTime5 = (delta5 / MAX_SPEED_J5) * SPLINE_SAFETY_MARGIN * 1000000.0f;
  float minTime6 = (delta6 / MAX_SPEED_J6) * SPLINE_SAFETY_MARGIN * 1000000.0f;

  // Acceleration duration constraint: T_accel = sqrt(6.0 * delta / MAX_ACCEL) * 1e6 us
  float tAcc1 = (MAX_ACCEL_J1 > 0.0f) ? sqrtf((6.0f * delta1) / MAX_ACCEL_J1) * 1000000.0f : 0.0f;
  float tAcc2 = (MAX_ACCEL_J2 > 0.0f) ? sqrtf((6.0f * delta2) / MAX_ACCEL_J2) * 1000000.0f : 0.0f;
  float tAcc3 = (MAX_ACCEL_J3 > 0.0f) ? sqrtf((6.0f * delta3) / MAX_ACCEL_J3) * 1000000.0f : 0.0f;
  float tAcc4 = (MAX_ACCEL_J4 > 0.0f) ? sqrtf((6.0f * delta4) / MAX_ACCEL_J4) * 1000000.0f : 0.0f;
  float tAcc5 = (MAX_ACCEL_J5 > 0.0f) ? sqrtf((6.0f * delta5) / MAX_ACCEL_J5) * 1000000.0f : 0.0f;
  float tAcc6 = (MAX_ACCEL_J6 > 0.0f) ? sqrtf((6.0f * delta6) / MAX_ACCEL_J6) * 1000000.0f : 0.0f;

  float minRequiredTime = max(minTime1, max(minTime2, max(minTime3, max(minTime4, max(minTime5, minTime6)))));
  float minAccTime = max(tAcc1, max(tAcc2, max(tAcc3, max(tAcc4, max(tAcc5, tAcc6)))));
  minRequiredTime = max(minRequiredTime, minAccTime);

  float baseDurationUs = max(requestedDurationMs * 1000.0f, minRequiredTime);
  float plannedScale = 1.0f;

  uint8_t pending = (qHead - qTail + WAYPOINT_QUEUE_SIZE) % WAYPOINT_QUEUE_SIZE;
  uint8_t lookAheadSteps = pending > 1 ? pending - 1 : 0;
  if (lookAheadSteps > LOOKAHEAD_WAYPOINTS) lookAheadSteps = LOOKAHEAD_WAYPOINTS;

  for (uint8_t offset = 1; offset <= lookAheadSteps; ++offset) {
    uint8_t futureIdx = (qTail + offset) % WAYPOINT_QUEUE_SIZE;
    if (futureIdx == qHead) break;
    float transitionScale = estimateLookAheadScale(currentPos, currentTarget, motionQueue[futureIdx]);
    if (transitionScale < plannedScale) {
      plannedScale = transitionScale;
    }
  }

  if (plannedScale < 0.999f) {
    baseDurationUs *= (1.0f / plannedScale);
  }

  return baseDurationUs;
}

void blendActiveSpline(const Waypoint &wpTarget) {
  if (!isMovingQueue) return;

  // Snapshot active trajectory state with atomic copy
  noInterrupts();
  MotionTrajectory curTraj = activeTrajectory;
  float curSplineDuration = splineDuration;
  float curSplineT = splineT;
  float curSpeedOverride = speedOverride;
  interrupts();

  float currentOverride = max(0.05f, curSpeedOverride);
  float realDuration_us = curSplineDuration / currentOverride;
  if (realDuration_us < 1000.0f) realDuration_us = 1000.0f;

  float t = constrain(curSplineT, 0.0f, 1.0f);
  float pos1, vel1, acc1;
  float pos2, vel2, acc2;
  float pos3, vel3, acc3;
  float pos4, vel4, acc4;
  float pos5, vel5, acc5;
  float pos6, vel6, acc6;

  evaluateCubic(curTraj.coeffJ1, t, pos1, vel1, acc1);
  evaluateCubic(curTraj.coeffJ2, t, pos2, vel2, acc2);
  evaluateCubic(curTraj.coeffJ3, t, pos3, vel3, acc3);
  evaluateCubic(curTraj.coeffJ4, t, pos4, vel4, acc4);
  evaluateCubic(curTraj.coeffJ5, t, pos5, vel5, acc5);
  evaluateCubic(curTraj.coeffJ6, t, pos6, vel6, acc6);

  float realDuration_s = realDuration_us / 1000000.0f;
  if (realDuration_s < 0.001f) realDuration_s = 0.001f;

  SplinePoint local_sp1 = { pos1, pos2, pos3, pos4, pos5, pos6 };
  SplinePoint local_sp2 = { wpTarget.j1, wpTarget.j2, wpTarget.j3, wpTarget.j4, wpTarget.j5, wpTarget.j6 };
  SplinePoint local_sv1 = { vel1 / realDuration_s, vel2 / realDuration_s, vel3 / realDuration_s, vel4 / realDuration_s, vel5 / realDuration_s, vel6 / realDuration_s };
  SplinePoint local_sa1 = { acc1 / (realDuration_s * realDuration_s), acc2 / (realDuration_s * realDuration_s), acc3 / (realDuration_s * realDuration_s), acc4 / (realDuration_s * realDuration_s), acc5 / (realDuration_s * realDuration_s), acc6 / (realDuration_s * realDuration_s) };

  // Destination velocity must be zero for blend move stopping at target
  SplinePoint local_sv2 = { 0.0f, 0.0f, 0.0f, 0.0f, 0.0f, 0.0f };
  SplinePoint local_sa2 = { 0.0f, 0.0f, 0.0f, 0.0f, 0.0f, 0.0f };

  float remainingUs = max(1000.0f, (1.0f - t) * realDuration_us);
  float newDuration_s = remainingUs / 1000000.0f;
  if (newDuration_s < 0.001f) newDuration_s = 0.001f;

  MotionTrajectory newTrajectory;
  solveCubicHermite(local_sp1.j1, local_sp2.j1, local_sv1.j1, local_sv2.j1, newDuration_s, newTrajectory.coeffJ1, local_sa1.j1, local_sa2.j1);
  solveCubicHermite(local_sp1.j2, local_sp2.j2, local_sv1.j2, local_sv2.j2, newDuration_s, newTrajectory.coeffJ2, local_sa1.j2, local_sa2.j2);
  solveCubicHermite(local_sp1.j3, local_sp2.j3, local_sv1.j3, local_sv2.j3, newDuration_s, newTrajectory.coeffJ3, local_sa1.j3, local_sa2.j3);
  solveCubicHermite(local_sp1.j4, local_sp2.j4, local_sv1.j4, local_sv2.j4, newDuration_s, newTrajectory.coeffJ4, local_sa1.j4, local_sa2.j4);
  solveCubicHermite(local_sp1.j5, local_sp2.j5, local_sv1.j5, local_sv2.j5, newDuration_s, newTrajectory.coeffJ5, local_sa1.j5, local_sa2.j5);
  solveCubicHermite(local_sp1.j6, local_sp2.j6, local_sv1.j6, local_sv2.j6, newDuration_s, newTrajectory.coeffJ6, local_sa1.j6, local_sa2.j6);

  newTrajectory.durationUs = remainingUs;
  newTrajectory.duration_s = newDuration_s;

  noInterrupts();
  activeTrajectory = newTrajectory;
  splineDuration = remainingUs * currentOverride; // Store base duration to prevent double-scaling in ISR
  activeSegmentDuration_s = newDuration_s;
  sp1 = local_sp1;
  sp2 = local_sp2;
  sv1 = local_sv1;
  sv2 = local_sv2;
  sa1 = local_sa1;
  sa2 = local_sa2;
  currentVelJ1 = local_sv1.j1;
  currentVelJ2 = local_sv1.j2;
  currentVelJ3 = local_sv1.j3;
  currentVelJ4 = local_sv1.j4;
  currentVelJ5 = local_sv1.j5;
  currentVelJ6 = local_sv1.j6;
  currentAccJ1 = local_sa1.j1;
  currentAccJ2 = local_sa1.j2;
  currentAccJ3 = local_sa1.j3;
  currentAccJ4 = local_sa1.j4;
  currentAccJ5 = local_sa1.j5;
  currentAccJ6 = local_sa1.j6;
  spPrev = local_sp1;
  splineT = 0.0f;
  lastSplineTime = micros();

  lastSpdJ1 = constrain(local_sv1.j1 * stepsPerDegAxis1, -MAX_SPEED_J1, MAX_SPEED_J1);
  lastSpdJ2 = constrain(local_sv1.j2 * stepsPerDegGeared, -MAX_SPEED_J2, MAX_SPEED_J2);
  lastSpdJ3 = constrain(local_sv1.j3 * stepsPerDegGeared * J3_STEP_SIGN, -MAX_SPEED_J3, MAX_SPEED_J3);
  lastSpdJ4 = constrain(local_sv1.j4 * stepsPerDegAxis4, -MAX_SPEED_J4, MAX_SPEED_J4);
  lastSpdJ5 = constrain(local_sv1.j5 * stepsPerDegAxis5, -MAX_SPEED_J5, MAX_SPEED_J5);
  lastSpdJ6 = constrain(local_sv1.j6 * stepsPerDegAxis6, -MAX_SPEED_J6, MAX_SPEED_J6);

  motionQueue[qTail] = wpTarget;
  applyRunCurrent();
  interrupts();
}

// ── Tool & Work Frame Offsets ────────────────────────────────────────────
struct OffsetFrame { float x = 0, y = 0, z = 0; };
OffsetFrame toolOffset;  // TCP deviation from nominal tool length, in flange coordinates (mm)
OffsetFrame workOffset;  // work-object origin shift (mm)

// Four flange poses with the same physical TCP held at a fixed world point.
struct TcpCalPose { float p5[3]; float R06[3][3]; bool valid = false; };
TcpCalPose tcpCalPoses[4];

// ── Teach Mode ───────────────────────────────────────────────────────────
struct TeachPoint { float j1, j2, j3, j4, j5, j6, grip; };
const uint8_t MAX_TEACH_POINTS = 64;
TeachPoint teachPoints[MAX_TEACH_POINTS];
uint8_t teachCount   = 0;
uint8_t teachPlayIdx = 0;
bool isTeachMode     = false;  // arm in teach-recording mode
volatile bool isTeachPlaying = false; // Written by motionLoopISR during a controlled stop.

// ── EEPROM Static Layout Verification ─────────────────────────────────────
static_assert(EEPROM_TOOL_OFF_ADDR + sizeof(OffsetFrame) <= EEPROM_WORK_OFF_ADDR, "EEPROM: Tool and Work offset regions overlap!");
static_assert(EEPROM_WORK_OFF_ADDR + sizeof(OffsetFrame) <= EEPROM_MAXSPD_ADDR, "EEPROM: Work offset and Max Speed regions overlap!");
static_assert(EEPROM_TEACH_DATA_ADDR + (MAX_TEACH_POINTS * sizeof(TeachPoint)) <= 2048, "EEPROM: Teach data exceeds allocated space!");

// ── Non-Blocking Homing State Machine ───────────────────────────────────
enum HomingState {
  HOMING_IDLE,
  HOMING_J1_FAST, HOMING_J1_BACKOFF, HOMING_J1_SLOW,
  HOMING_J2_FAST, HOMING_J2_BACKOFF, HOMING_J2_SLOW,
  HOMING_J3_FAST, HOMING_J3_BACKOFF, HOMING_J3_SLOW,
  HOMING_COMPLETE, HOMING_FAULT
};
HomingState homingState  = HOMING_IDLE;
bool homingDoJ1 = false, homingDoJ2 = false, homingDoJ3 = false;
uint8_t homingRetries    = 0;
unsigned long homingStepCount = 0;
const uint8_t MAX_HOME_RETRIES_NB = 3;

// Function Prototypes
void calculateIK(float x, float y, float z, unsigned long duration = 1000,
                 WristMode wristMode = WristMode::LEVEL,
                 float j4_manual_deg = 0.0f, float j5_deg = 0.0f, bool isMovL = false, float j6_deg = 0.0f);
void calculateIK6DOF(float x, float y, float z, float roll_deg, float pitch_deg, float yaw_deg,
                     unsigned long duration = 1000, bool isMovL = false);
void moveToAngles(float theta1, float theta2, float theta3,
                  unsigned long duration_ms, bool skipWorkspaceCheck = false,
                  float t4 = -999.0f, float t5 = -999.0f, bool isMovL = false, float t6 = -999.0f);
void movL(float x2, float y2, float z2, unsigned long duration = 2000,
          WristMode wristMode = WristMode::LEVEL, float j4 = 0.0f, float j5 = 0.0f, float j6 = 0.0f);
void movL6DOF(float x2, float y2, float z2, float r2, float p2, float yw2, unsigned long duration = 2000);
void parseCommand(const char *command, float value);
void parsePacket(const char *data);
void processInput(Stream &stream, char *buffer, uint8_t &pos, size_t bufSize);
void printDriver(const char *name, TMC2209Stepper &driver);
uint16_t readAS5600(TwoWire &wire);
uint16_t readEncoderRetry(TwoWire &wire, uint8_t maxAttempts = 3);
void updateClosedLoop();
float getEncoderAngle(uint16_t raw, float offset);
void queueCalibrationWaypoint(float t1, float t2, float t3, unsigned long duration_ms);
void checkCalTestResults();
void printBacklash();
void parseBacklashCommand(const char *args);
void loadBacklashFromEEPROM();
void saveBacklashToEEPROM();

// ── EEPROM helpers ────────────────────────────────────────────────────────
bool eeprom_valid();
void eeprom_save_all();
void eeprom_load_all();

// ── Forward Kinematics ───────────────────────────────────────────────────
void forwardKinematics(float j1_deg, float j2_deg, float j3_deg,
                       float &x, float &y, float &z, bool raw = false,
                       float j4_deg = 0.0f, float j5_deg = 0.0f, float j6_deg = 0.0f);
void forwardKinematics6DOF(float j1_deg, float j2_deg, float j3_deg, float j4_deg, float j5_deg, float j6_deg,
                           float &x, float &y, float &z, float &roll_deg, float &pitch_deg, float &yaw_deg, bool raw = false);
void captureCurrentWristFrame(TcpCalPose &pose);
bool solveTcp4Point(float tcpOut[3], float &rmsErrorMm);

// ── Workspace check ──────────────────────────────────────────────────────
bool checkWorkspace(float j1, float j2, float j3, float j4 = 0.0f, float j5 = 0.0f, float j6 = 0.0f);

// ── Homing ───────────────────────────────────────────────────────────────
void startHoming(bool doJ1, bool doJ2, bool doJ3);
void updateHoming();           // called every loop() — non-blocking

// ── AR4-format responses ─────────────────────────────────────────────────
void sendRobotPos();
void sendACK();
void sendError(const char *code);
void sendJSONTelemetry();      // JSON telemetry stream

// ── Encoder collision detection ──────────────────────────────────────────
void checkEncoders();

// ── iHold current management ─────────────────────────────────────────────
void applyHoldCurrent();
void applyRunCurrent();
void applySpeedOverride();

// (SD card teach/playback functions removed)

// ── Gripper ──────────────────────────────────────────────────────────────
void setGripper(float angle);

// ── Teach Mode ───────────────────────────────────────────────────────────
void updateTeachPlayback();

// ================= GRIPPER =================
void setGripper(float angle) {
  gripperAngle = constrain(angle, 0.0f, 180.0f);
  gripper.write((int)gripperAngle);
}

// ================= JSON TELEMETRY =================
void sendJSONTelemetry() {
  float cx, cy, cz;
  forwardKinematics(commandedAngle1, commandedAngle2, commandedAngle3, cx, cy, cz, false, commandedAngle4, commandedAngle5, commandedAngle6);
  char buf[350];
  const char *estop_str = estopActive ? "true" : "false";
  const char *homing_str = (homingState != HOMING_IDLE) ? "true" : "false";
  const char *teach_str = isTeachMode ? "true" : "false";
  int spd = (int)(speedOverride * 100);
  float j4_val = constrain(commandedAngle4, LIMIT_J4_MIN, LIMIT_J4_MAX);
  float j5_val = constrain(commandedAngle5, LIMIT_J5_MIN, LIMIT_J5_MAX);
  float j6_val = constrain(commandedAngle6, LIMIT_J6_MIN, LIMIT_J6_MAX);
  snprintf(buf, sizeof(buf),
    "{\"j1\":%.2f,\"j2\":%.2f,\"j3\":%.2f,"
    "\"j4\":%.1f,\"j5\":%.1f,\"j6\":%.1f,\"grip\":%d,"
    "\"x\":%.1f,\"y\":%.1f,\"z\":%.1f,"
    "\"spd\":%d,\"estop\":%s,\"homing\":%s,\"teach\":%s,\"tpts\":%d}",
    commandedAngle1, commandedAngle2, commandedAngle3,
    j4_val, j5_val, j6_val, (int)gripperAngle,
    cx, cy, cz,
    spd, estop_str, homing_str, teach_str, teachCount);
  Serial.println(buf);
}

// ================= LINEAR CARTESIAN MOVE (MOVL) =================
void movL(float x2, float y2, float z2, unsigned long duration,
          WristMode wristMode, float j4, float j5, float j6) {
  // Compute current TCP via FK
  float x1, y1, z1;
  forwardKinematics(commandedAngle1, commandedAngle2, commandedAngle3, x1, y1, z1, false, commandedAngle4, commandedAngle5, commandedAngle6);

  float dx = x2 - x1, dy = y2 - y1, dz = z2 - z1;
  float dist = sqrtf(dx*dx + dy*dy + dz*dz);
  if (dist < 1.0f) { // already there (< 1 mm), just do IK directly
    calculateIK(x2, y2, z2, duration, wristMode, j4, j5, false, j6);
    return;
  }

  // Determine number of segments (aim for ~5 mm per step, capped at 30)
  int segs = (int)(dist / 5.0f);
  segs = constrain(segs, 2, 30);
  unsigned long segDur = duration / (unsigned long)segs;
  if (segDur < 50UL) {
    segs = max(1, (int)(duration / 50UL));
    segDur = (segs > 0) ? duration / (unsigned long)segs : duration;
    segDur = max(segDur, 50UL);
  }

  Serial.print("MOVL: dist="); Serial.print(dist, 1);
  Serial.print("mm segs="); Serial.println(segs);

  float sj4 = commandedAngle4;
  float sj5 = commandedAngle5;
  float sj6 = commandedAngle6;

  for (int i = 1; i <= segs; i++) {
    float t = (float)i / segs;
    float xi = x1 + dx * t;
    float yi = y1 + dy * t;
    float zi = z1 + dz * t;
    float ji4 = sj4 + (j4 - sj4) * t;
    float ji5 = sj5 + (j5 - sj5) * t;
    float ji6 = sj6 + (j6 - sj6) * t;
    // calculateIK will enqueue into the waypoint queue
    calculateIK(xi, yi, zi, segDur, wristMode, ji4, ji5, true, ji6);
  }
}

// ================= QUATERNION HELPERS (for MOVL6DOF SLERP) =================
// Euler convention: ZYX intrinsic, R06 = Rz(yaw) * Ry(pitch) * Rx(roll)
// (identical to calculateIK6DOF() / forwardKinematics6DOF()).
static Quat eulerToQuat(float roll_deg, float pitch_deg, float yaw_deg) {
  const float hr = roll_deg  * DEG_TO_RAD * 0.5f;
  const float hp = pitch_deg * DEG_TO_RAD * 0.5f;
  const float hy = yaw_deg   * DEG_TO_RAD * 0.5f;
  const float cr = cosf(hr), sr = sinf(hr);
  const float cp = cosf(hp), sp = sinf(hp);
  const float cy = cosf(hy), sy = sinf(hy);

  Quat q;
  q.w = cr * cp * cy + sr * sp * sy;
  q.x = sr * cp * cy - cr * sp * sy;
  q.y = cr * sp * cy + sr * cp * sy;
  q.z = cr * cp * sy - sr * sp * cy;
  return q;
}

static void quatToEuler(const Quat &q, float &roll_deg, float &pitch_deg, float &yaw_deg) {
  // roll (X)
  float sinr_cosp = 2.0f * (q.w * q.x + q.y * q.z);
  float cosr_cosp = 1.0f - 2.0f * (q.x * q.x + q.y * q.y);
  roll_deg = atan2f(sinr_cosp, cosr_cosp) * RAD_TO_DEG;

  // pitch (Y) - clamp asin() argument to avoid NaN at +-90 deg
  float sinp = constrain(2.0f * (q.w * q.y - q.z * q.x), -1.0f, 1.0f);
  pitch_deg = asinf(sinp) * RAD_TO_DEG;

  // yaw (Z)
  float siny_cosp = 2.0f * (q.w * q.z + q.x * q.y);
  float cosy_cosp = 1.0f - 2.0f * (q.y * q.y + q.z * q.z);
  yaw_deg = atan2f(siny_cosp, cosy_cosp) * RAD_TO_DEG;
}

static Quat quatSlerp(Quat q1, Quat q2, float t) {
  float dot = q1.w * q2.w + q1.x * q2.x + q1.y * q2.y + q1.z * q2.z;

  // Shortest-path hemisphere check (q and -q are the same rotation)
  if (dot < 0.0f) {
    q2.w = -q2.w; q2.x = -q2.x; q2.y = -q2.y; q2.z = -q2.z;
    dot = -dot;
  }

  float s1, s2;
  if (dot > 0.9995f) {
    // Nearly identical orientations: NLERP (avoids division by ~0 sin(theta))
    s1 = 1.0f - t;
    s2 = t;
  } else {
    float theta0 = acosf(constrain(dot, -1.0f, 1.0f));
    float theta  = theta0 * t;
    float sinTheta0 = sinf(theta0);
    s1 = sinf(theta0 - theta) / sinTheta0;
    s2 = sinf(theta) / sinTheta0;
  }

  Quat out;
  out.w = s1 * q1.w + s2 * q2.w;
  out.x = s1 * q1.x + s2 * q2.x;
  out.y = s1 * q1.y + s2 * q2.y;
  out.z = s1 * q1.z + s2 * q2.z;

  float n = sqrtf(out.w * out.w + out.x * out.x + out.y * out.y + out.z * out.z);
  if (n > 1e-9f) {
    float inv = 1.0f / n;
    out.w *= inv; out.x *= inv; out.y *= inv; out.z *= inv;
  } else {
    out = q1; // Degenerate fallback
  }
  return out;
}

// ================= LINEAR CARTESIAN 6-DOF MOVE (MOVL6DOF) =================
void movL6DOF(float x2, float y2, float z2, float r2, float p2, float yw2, unsigned long duration) {
  float x1, y1, z1, r1, p1, yw1;
  forwardKinematics6DOF(commandedAngle1, commandedAngle2, commandedAngle3, commandedAngle4, commandedAngle5, commandedAngle6,
                        x1, y1, z1, r1, p1, yw1, false);

  float dx = x2 - x1;
  float dy = y2 - y1;
  float dz = z2 - z1;
  float dist = sqrtf(dx * dx + dy * dy + dz * dz);

  // Orientation: SLERP between start and target quaternions
  Quat q1 = eulerToQuat(r1, p1, yw1);
  Quat q2 = eulerToQuat(r2, p2, yw2);
  float qdot = q1.w * q2.w + q1.x * q2.x + q1.y * q2.y + q1.z * q2.z;
  float totalRotDeg = 2.0f * acosf(constrain(fabsf(qdot), 0.0f, 1.0f)) * RAD_TO_DEG;

  int segs = (int)ceilf(dist / 5.0f);
  int rotSegs = (int)ceilf(totalRotDeg / 5.0f);
  if (rotSegs > segs) segs = rotSegs;
  segs = constrain(segs, 1, 30); // Capped to fit within WAYPOINT_QUEUE_SIZE

  unsigned long segDur = (unsigned long)(duration / segs);
  if (segDur < 50UL) {
    segDur = 50UL;
  }

  Serial.print("MOVL6DOF: dist="); Serial.print(dist, 1);
  Serial.print("mm rot="); Serial.print(totalRotDeg, 1);
  Serial.print("deg segs="); Serial.println(segs);

  for (int i = 1; i <= segs; i++) {
    float t = (float)i / segs;
    float xi = x1 + dx * t;
    float yi = y1 + dy * t;
    float zi = z1 + dz * t;
    Quat qi = quatSlerp(q1, q2, t);
    float ri, pi, ywi;
    quatToEuler(qi, ri, pi, ywi);
    calculateIK6DOF(xi, yi, zi, ri, pi, ywi, segDur, true);
  }
}

// ================= TEACH MODE PLAYBACK =================
void updateTeachPlayback() {
  if (!isTeachPlaying) return;
  if (isMovingQueue || qHead != qTail) return; // wait for current move to finish

  if (teachPlayIdx >= teachCount) {
    isTeachPlaying = false;
    teachPlayIdx = 0;
    Serial.println("TEACH: Playback complete");
    sendACK();
    return;
  }

  TeachPoint &tp = teachPoints[teachPlayIdx++];
  float d1 = fabsf(tp.j1 - commandedAngle1);
  float d2 = fabsf(tp.j2 - commandedAngle2);
  float d3 = fabsf(tp.j3 - commandedAngle3);
  float d4 = fabsf(tp.j4 - commandedAngle4);
  float d5 = fabsf(tp.j5 - commandedAngle5);
  float d6 = fabsf(tp.j6 - commandedAngle6);
  float maxD = max(max(max(d1, d2), max(d3, d4)), max(d5, d6));
  unsigned long dur = constrain((unsigned long)(maxD * 25.0f), 500UL, 3000UL);
  moveToAngles(tp.j1, tp.j2, tp.j3, dur, false, tp.j4, tp.j5, false, tp.j6);
  setGripper(tp.grip);
}

// ================= NON-BLOCKING HOMING =================
void startHoming(bool doJ1, bool doJ2, bool doJ3) {
  if (estopActive) {
    Serial.println("ERR: Cannot home while ESTOP active");
    return;
  }
  noInterrupts();
  homingDoJ1 = doJ1; homingDoJ2 = doJ2; homingDoJ3 = doJ3;
  homingRetries = 0;
  homingStepCount = 0;
  qHead = 0; qTail = 0; isMovingQueue = false;
  wasContinuous = false;
  motionLoopActive = false;
  currentVelJ1 = 0.0f; currentVelJ2 = 0.0f; currentVelJ3 = 0.0f;
  currentVelJ4 = 0.0f; currentVelJ5 = 0.0f; currentVelJ6 = 0.0f;
  currentAccJ1 = 0.0f; currentAccJ2 = 0.0f; currentAccJ3 = 0.0f;
  currentAccJ4 = 0.0f; currentAccJ5 = 0.0f; currentAccJ6 = 0.0f;
  lastSpdJ1 = 0.0f; lastSpdJ2 = 0.0f; lastSpdJ3 = 0.0f;
  lastSpdJ4 = 0.0f; lastSpdJ5 = 0.0f; lastSpdJ6 = 0.0f;
  lastAccJ1 = 0.0f; lastAccJ2 = 0.0f; lastAccJ3 = 0.0f;
  lastAccJ4 = 0.0f; lastAccJ5 = 0.0f; lastAccJ6 = 0.0f;
  for (int i = 0; i < 6; ++i) {
    backlashOffsetSteps[i] = 0.0f;
    lastDirection[i] = 0;
  }
  interrupts();

  // Apply homing speeds
  stepper1.setMaxSpeed(20000.0f);
  stepper2.setMaxSpeed(35000.0f);
  stepper3.setMaxSpeed(25000.0f);

  Serial.println("HOMING: Starting (non-blocking)...");

  if (doJ1) {
    homingState = HOMING_J1_FAST;
    stepper1.setSpeed(-stepsPerDegAxis1 * 20.0f);  // 20 deg/s fast
  } else if (doJ2) {
    homingState = HOMING_J2_FAST;
    stepper2.setSpeed(-stepsPerDegGeared * 20.0f);
  } else if (doJ3) {
    homingState = HOMING_J3_FAST;
    stepper3.setSpeed(-stepsPerDegGeared * 20.0f * J3_STEP_SIGN);
  }
}

// FIX B-3: Non-blocking paced homing with runSpeed() step counting
void updateHoming() {
  if (homingState == HOMING_IDLE || homingState == HOMING_COMPLETE || homingState == HOMING_FAULT)
    return;

  const long MAX_FAST_STEPS  = (long)(200.0f * stepsPerDegGeared);
  const long BACKOFF_STEPS   = (long)(5.0f   * stepsPerDegGeared);
  const float SLOW_SPD_DEG   = 2.0f;

  switch (homingState) {

    // ── J1 FAST ─────────────────────────────────────────────────────────
    case HOMING_J1_FAST:
      if (stepper1.runSpeed()) homingStepCount++;
      if (digitalRead(PIN_J1_LIMIT) == HIGH) {
        stepper1.setSpeed(stepsPerDegAxis1 * SLOW_SPD_DEG); // reverse
        homingStepCount = 0;
        homingState = HOMING_J1_BACKOFF;
        Serial.print("HOMING J1 backoff... ");
      } else if (homingStepCount > (unsigned long)(180.0f * stepsPerDegAxis1)) {
        if (++homingRetries >= MAX_HOME_RETRIES_NB) {
          homingState = HOMING_FAULT;
          Serial.println("ERR:HOME_FAULT_J1");
        } else {
          stepper1.setSpeed(stepsPerDegAxis1 * SLOW_SPD_DEG);
          homingStepCount = 0;
          homingState = HOMING_J1_BACKOFF;
        }
      }
      break;

    case HOMING_J1_BACKOFF:
      if (stepper1.runSpeed()) homingStepCount++;
      if (homingStepCount >= (unsigned long)(5.0f * stepsPerDegAxis1)) {
        stepper1.setSpeed(-stepsPerDegAxis1 * SLOW_SPD_DEG);
        homingStepCount = 0;
        homingState = HOMING_J1_SLOW;
        Serial.print("slow... ");
      }
      break;

    case HOMING_J1_SLOW:
      if (stepper1.runSpeed()) homingStepCount++;
      if (digitalRead(PIN_J1_LIMIT) == HIGH) {
        stepper1.setCurrentPosition(0);
        noInterrupts();
        commandedAngle1 = 0.0f;
        interrupts();
        if (encEnabled[0]) {
          uint16_t raw = readAS5600(Wire2);
          if (raw != 0xFFFF) enc1Offset = (raw / 4096.0f) * 360.0f - commandedAngle1;
        }
        Serial.println("OK");
        homingRetries = 0; homingStepCount = 0;
        if (homingDoJ2) {
          stepper2.setSpeed(-stepsPerDegGeared * 20.0f);
          homingState = HOMING_J2_FAST;
          Serial.print("HOMING J2 fast... ");
        } else if (homingDoJ3) {
          stepper3.setSpeed(-stepsPerDegGeared * 20.0f * J3_STEP_SIGN);
          homingState = HOMING_J3_FAST;
          Serial.print("HOMING J3 fast... ");
        } else {
          homingState = HOMING_COMPLETE;
        }
      } else if (homingStepCount > (unsigned long)(10.0f * stepsPerDegAxis1)) {
        homingState = HOMING_FAULT;
        Serial.println("ERR:HOME_FAULT_J1_SLOW");
      }
      break;

    // ── J2 FAST ─────────────────────────────────────────────────────────
    case HOMING_J2_FAST:
      if (stepper2.runSpeed()) homingStepCount++;
      if (digitalRead(PIN_J2_LIMIT) == HIGH) {
        stepper2.setSpeed(stepsPerDegGeared * SLOW_SPD_DEG);
        homingStepCount = 0;
        homingState = HOMING_J2_BACKOFF;
        Serial.print("HOMING J2 backoff... ");
      } else if (homingStepCount > (unsigned long)MAX_FAST_STEPS) {
        if (++homingRetries >= MAX_HOME_RETRIES_NB) {
          homingState = HOMING_FAULT;
          Serial.println("ERR:HOME_FAULT_J2");
        } else {
          stepper2.setSpeed(stepsPerDegGeared * SLOW_SPD_DEG);
          homingStepCount = 0;
          homingState = HOMING_J2_BACKOFF;
        }
      }
      break;

    case HOMING_J2_BACKOFF:
      if (stepper2.runSpeed()) homingStepCount++;
      if (homingStepCount >= (unsigned long)BACKOFF_STEPS) {
        stepper2.setSpeed(-stepsPerDegGeared * SLOW_SPD_DEG);
        homingStepCount = 0;
        homingState = HOMING_J2_SLOW;
        Serial.print("slow... ");
      }
      break;

    case HOMING_J2_SLOW:
      if (stepper2.runSpeed()) homingStepCount++;
      if (digitalRead(PIN_J2_LIMIT) == HIGH) {
        stepper2.setCurrentPosition((long)(LIMIT_J2_MIN * stepsPerDegGeared));
        noInterrupts();
        commandedAngle2 = LIMIT_J2_MIN;
        interrupts();
        if (encEnabled[1]) {
          uint16_t raw = readAS5600(Wire);
          if (raw != 0xFFFF) enc2Offset = (raw / 4096.0f) * 360.0f - commandedAngle2;
        }
        Serial.println("OK");
        homingRetries = 0; homingStepCount = 0;
        if (homingDoJ3) {
          stepper3.setSpeed(-stepsPerDegGeared * 20.0f * J3_STEP_SIGN);
          homingState = HOMING_J3_FAST;
          Serial.print("HOMING J3 fast... ");
        } else {
          homingState = HOMING_COMPLETE;
        }
      } else if (homingStepCount > (unsigned long)(10.0f * stepsPerDegGeared)) {
        homingState = HOMING_FAULT;
        Serial.println("ERR:HOME_FAULT_J2_SLOW");
      }
      break;

    // ── J3 FAST ─────────────────────────────────────────────────────────
    case HOMING_J3_FAST:
      if (stepper3.runSpeed()) homingStepCount++;
      if (digitalRead(PIN_J3_LIMIT) == HIGH) {
        stepper3.setSpeed(stepsPerDegGeared * SLOW_SPD_DEG * J3_STEP_SIGN);
        homingStepCount = 0;
        homingState = HOMING_J3_BACKOFF;
        Serial.print("HOMING J3 backoff... ");
      } else if (homingStepCount > (unsigned long)MAX_FAST_STEPS) {
        if (++homingRetries >= MAX_HOME_RETRIES_NB) {
          homingState = HOMING_FAULT;
          Serial.println("ERR:HOME_FAULT_J3");
        } else {
          stepper3.setSpeed(stepsPerDegGeared * SLOW_SPD_DEG * J3_STEP_SIGN);
          homingStepCount = 0;
          homingState = HOMING_J3_BACKOFF;
        }
      }
      break;

    case HOMING_J3_BACKOFF:
      if (stepper3.runSpeed()) homingStepCount++;
      if (homingStepCount >= (unsigned long)BACKOFF_STEPS) {
        stepper3.setSpeed(-stepsPerDegGeared * SLOW_SPD_DEG * J3_STEP_SIGN);
        homingStepCount = 0;
        homingState = HOMING_J3_SLOW;
        Serial.print("slow... ");
      }
      break;

    case HOMING_J3_SLOW:
      if (stepper3.runSpeed()) homingStepCount++;
      if (digitalRead(PIN_J3_LIMIT) == HIGH) {
        stepper3.setCurrentPosition(j3AngleToSteps(LIMIT_J3_MIN));
        noInterrupts();
        commandedAngle3 = LIMIT_J3_MIN;
        interrupts();
        if (encEnabled[2]) {
          uint16_t raw = readAS5600(Wire1);
          if (raw != 0xFFFF) enc3Offset = (raw / 4096.0f) * 360.0f - commandedAngle3;
        }
        Serial.println("OK");
        homingState = HOMING_COMPLETE;
      } else if (homingStepCount > (unsigned long)(10.0f * stepsPerDegGeared)) {
        homingState = HOMING_FAULT;
        Serial.println("ERR:HOME_FAULT_J3_SLOW");
      }
      break;

    case HOMING_COMPLETE:
      applySpeedOverride();
      for (int i = 0; i < 6; ++i) {
        backlashOffsetSteps[i] = 0.0f;
        lastDirection[i] = 0;
      }
      isHomed = true;
      moveToAngles(0.0f, 0.0f, 0.0f, 3000, true, 0.0f, 0.0f, false, 0.0f);
      sendACK();
      Serial.println("HOMING: Complete (Arm at Home 0,0,0,0,0,0)");
      homingState = HOMING_IDLE;
      break;

    case HOMING_FAULT:
      homingStepCount = 0;
      homingRetries = 0;
      Serial.println("HOMING: FAULT - some axes failed");
      homingState = HOMING_IDLE;
      break;

    default:
      break;
  }
}

// ================= EEPROM HELPERS =================
bool eeprom_valid() {
  uint32_t magic;
  EEPROM.get(EEPROM_MAGIC_ADDR, magic);
  return (magic == EEPROM_MAGIC_NUMBER);
}

void eeprom_save_all() {
  uint32_t magic = EEPROM_MAGIC_NUMBER;
  EEPROM.put(EEPROM_MAGIC_ADDR, magic);
  EEPROM.put(EEPROM_GEAR1_ADDR, gearboxRatioAxis1);
  EEPROM.put(EEPROM_GEAR2_ADDR, gearboxRatio);
  EEPROM.put(EEPROM_JNT_EN_ADDR,     (uint8_t)jointEnabled[0]);
  EEPROM.put(EEPROM_JNT_EN_ADDR + 1, (uint8_t)jointEnabled[1]);
  EEPROM.put(EEPROM_JNT_EN_ADDR + 2, (uint8_t)jointEnabled[2]);
  float spdOvrToSave = speedOverride;
  EEPROM.put(EEPROM_SPEED_OVR_ADDR, spdOvrToSave);
  EEPROM.put(EEPROM_TOOL_OFF_ADDR,  toolOffset);
  EEPROM.put(EEPROM_WORK_OFF_ADDR,  workOffset);
  // Calibration data
  EEPROM.put(EEPROM_MAXSPD_ADDR,      MAX_SPEED_J1);
  EEPROM.put(EEPROM_MAXSPD_ADDR + 4,  MAX_SPEED_J2);
  EEPROM.put(EEPROM_MAXSPD_ADDR + 8,  MAX_SPEED_J3);
  EEPROM.put(EEPROM_MAXACC_ADDR,      MAX_ACCEL_J1);
  EEPROM.put(EEPROM_MAXACC_ADDR + 4,  MAX_ACCEL_J2);
  EEPROM.put(EEPROM_MAXACC_ADDR + 8,  MAX_ACCEL_J3);
  EEPROM.put(EEPROM_SAFETY_ADDR,      SPLINE_SAFETY_MARGIN);
  // Teach data
  EEPROM.put(EEPROM_TEACH_COUNT_ADDR, teachCount);
  for (uint8_t i = 0; i < teachCount && i < MAX_TEACH_POINTS; ++i) {
    EEPROM.put(EEPROM_TEACH_DATA_ADDR + i * sizeof(TeachPoint), teachPoints[i]);
  }
  saveBacklashToEEPROM();
}

void eeprom_load_all() {
  if (!eeprom_valid()) return;
  EEPROM.get(EEPROM_GEAR1_ADDR, gearboxRatioAxis1);
  EEPROM.get(EEPROM_GEAR2_ADDR, gearboxRatio);
  if (isnan(gearboxRatioAxis1) || gearboxRatioAxis1 <= 0.1f || gearboxRatioAxis1 > 1000.0f) gearboxRatioAxis1 = 8.33f;
  if (isnan(gearboxRatio) || gearboxRatio <= 0.1f || gearboxRatio > 1000.0f) gearboxRatio = 20.0f;
  stepsPerDegAxis1   = (STEPS_PER_MOTOR_REV * gearboxRatioAxis1) / 360.0;
  stepsPerDegGeared  = (STEPS_PER_MOTOR_REV * gearboxRatio)      / 360.0;
  uint8_t j0, j1, j2;
  EEPROM.get(EEPROM_JNT_EN_ADDR,     j0);
  EEPROM.get(EEPROM_JNT_EN_ADDR + 1, j1);
  EEPROM.get(EEPROM_JNT_EN_ADDR + 2, j2);
  jointEnabled[0] = (bool)j0;
  jointEnabled[1] = (bool)j1;
  jointEnabled[2] = (bool)j2;
  float loadedSpdOvr = 1.0f;
  EEPROM.get(EEPROM_SPEED_OVR_ADDR, loadedSpdOvr);
  speedOverride = constrain(loadedSpdOvr, 0.05f, 1.0f);
  EEPROM.get(EEPROM_TOOL_OFF_ADDR,  toolOffset);
  EEPROM.get(EEPROM_WORK_OFF_ADDR,  workOffset);

  // Validate offsets to prevent NaN issues
  if (isnan(toolOffset.x) || isnan(toolOffset.y) || isnan(toolOffset.z))
    toolOffset = {0, 0, 0};
  if (isnan(workOffset.x) || isnan(workOffset.y) || isnan(workOffset.z))
    workOffset = {0, 0, 0};

  // Load calibration data
  float tmp;
  EEPROM.get(EEPROM_MAXSPD_ADDR, tmp);
  if (!isnan(tmp) && tmp > 0) MAX_SPEED_J1 = tmp;
  EEPROM.get(EEPROM_MAXSPD_ADDR + 4, tmp);
  if (!isnan(tmp) && tmp > 0) MAX_SPEED_J2 = tmp;
  EEPROM.get(EEPROM_MAXSPD_ADDR + 8, tmp);
  if (!isnan(tmp) && tmp > 0) MAX_SPEED_J3 = tmp;
  EEPROM.get(EEPROM_MAXACC_ADDR, tmp);
  if (!isnan(tmp) && tmp > 0) MAX_ACCEL_J1 = tmp;
  EEPROM.get(EEPROM_MAXACC_ADDR + 4, tmp);
  if (!isnan(tmp) && tmp > 0) MAX_ACCEL_J2 = tmp;
  EEPROM.get(EEPROM_MAXACC_ADDR + 8, tmp);
  if (!isnan(tmp) && tmp > 0) MAX_ACCEL_J3 = tmp;
  MAX_JERK_J1 = MAX_ACCEL_J1 * 20.0f;
  MAX_JERK_J2 = MAX_ACCEL_J2 * 20.0f;
  MAX_JERK_J3 = MAX_ACCEL_J3 * 20.0f;
  EEPROM.get(EEPROM_SAFETY_ADDR, tmp);
  if (!isnan(tmp) && tmp >= 1.0f) {
    if (tmp > 2.2f) tmp = 1.88f; // Migrate legacy 2.5 safety margin to the quintic default
    SPLINE_SAFETY_MARGIN = tmp;
  }

  // Load Teach data
  uint8_t loadedTeachCount = 0;
  EEPROM.get(EEPROM_TEACH_COUNT_ADDR, loadedTeachCount);
  if (loadedTeachCount <= MAX_TEACH_POINTS) {
    teachCount = loadedTeachCount;
    for (uint8_t i = 0; i < teachCount; ++i) {
      EEPROM.get(EEPROM_TEACH_DATA_ADDR + i * sizeof(TeachPoint), teachPoints[i]);
    }
  }
  loadBacklashFromEEPROM();
}

// ================= FORWARD KINEMATICS =================
void forwardKinematics(float j1_deg, float j2_deg, float j3_deg,
                       float &x, float &y, float &z, bool raw,
                       float j4_deg, float j5_deg, float j6_deg) {
    float dummyRoll, dummyPitch, dummyYaw;
    forwardKinematics6DOF(j1_deg, j2_deg, j3_deg, j4_deg, j5_deg, j6_deg,
                           x, y, z, dummyRoll, dummyPitch, dummyYaw, raw);
}

// ================= BACKLASH EEPROM & MANAGEMENT =================
void saveBacklashToEEPROM() {
  uint32_t magic = BACKLASH_MAGIC;
  EEPROM.put(EEPROM_BACKLASH_ADDR, magic);
  for (int i = 0; i < 6; ++i) {
    EEPROM.put(EEPROM_BACKLASH_ADDR + 4 + i * sizeof(float), backlashConfig.backlashDeg[i]);
  }
}

void loadBacklashFromEEPROM() {
  uint32_t magic = 0;
  EEPROM.get(EEPROM_BACKLASH_ADDR, magic);
  if (magic == BACKLASH_MAGIC) {
    for (int i = 0; i < 6; ++i) {
      float v = 0.0f;
      EEPROM.get(EEPROM_BACKLASH_ADDR + 4 + i * sizeof(float), v);
      if (!isnan(v) && !isinf(v) && v >= 0.0f && v <= 5.0f) {
        backlashConfig.backlashDeg[i] = v;
      }
    }
  }
}

void printBacklash() {
  Serial.println("=== BACKLASH COMPENSATION ===");
  for (int i = 0; i < 6; ++i) {
    Serial.printf("  J%d: %.3f deg (offset %.1f steps)\n", i + 1, backlashConfig.backlashDeg[i], backlashOffsetSteps[i]);
  }
  Serial.println("=============================");
}

void parseBacklashCommand(const char *args) {
  int axis = 0;
  float val = 0.0f;
  if (sscanf(args, "J%d %f", &axis, &val) == 2 || sscanf(args, "%d %f", &axis, &val) == 2) {
    if (axis >= 1 && axis <= 6) {
      if (val >= 0.0f && val <= 5.0f) {
        backlashConfig.backlashDeg[axis - 1] = val;
        scheduleEepromSave();
        Serial.printf("Backlash J%d set to %.3f deg\n", axis, val);
      } else {
        Serial.println("ERR: Backlash value must be between 0.0 and 5.0 deg");
      }
    } else {
      Serial.println("ERR: Invalid axis (1-6)");
    }
  } else {
    Serial.println("ERR: Usage: BACKLASH [J<1-6> <deg>]");
  }
}

// ================= FOUR-POINT TCP CALIBRATION =================
void captureCurrentWristFrame(TcpCalPose &pose) {
    const float j1r = commandedAngle1 * DEG_TO_RAD;
    const float j2r = commandedAngle2 * DEG_TO_RAD;
    const float j3r = commandedAngle3 * DEG_TO_RAD;
    const float j4r = commandedAngle4 * DEG_TO_RAD;
    const float j5r = commandedAngle5 * DEG_TO_RAD;
    const float j6r = commandedAngle6 * DEG_TO_RAD;

    // Same J5 position and R03 * Rx(J4) * Ry(-J5) * Rx(J6) convention as FK6DOF.
    const float th1 = TH1_0 - j2r;
    const float th2 = TH2_0 - (j2r + j3r);
    const float j5Reach = L1 * sinf(th1) + L2 * sinf(th2);
    pose.p5[0] = j5Reach * cosf(j1r);
    pose.p5[1] = j5Reach * sinf(j1r);
    pose.p5[2] = BASE_H + L1 * cosf(th1) + L2 * cosf(th2);

    const float pitchBase = TOOL_REST_ANGLE + (j2r + j3r);
    const float c1 = cosf(j1r), s1 = sinf(j1r);
    const float cp = cosf(pitchBase), sp = sinf(pitchBase);
    const float R03[3][3] = {
      { c1 * cp, -s1, -c1 * sp },
      { s1 * cp,  c1, -s1 * sp },
      { sp,       0.0f, cp }
    };

    const float c4 = cosf(j4r), s4 = sinf(j4r);
    const float c5 = cosf(j5r), s5 = sinf(j5r);
    const float c6 = cosf(j6r), s6 = sinf(j6r);
    const float Rx4[3][3] = {
      { 1.0f, 0.0f, 0.0f },
      { 0.0f, c4, -s4 },
      { 0.0f, s4,  c4 }
    };
    const float Ry5[3][3] = {
      { c5, 0.0f, -s5 },
      { 0.0f, 1.0f, 0.0f },
      { s5, 0.0f,  c5 }
    };
    const float Rx6[3][3] = {
      { 1.0f, 0.0f, 0.0f },
      { 0.0f, c6, -s6 },
      { 0.0f, s6,  c6 }
    };

    float R35[3][3], R36[3][3];
    for (int row = 0; row < 3; ++row) {
      for (int col = 0; col < 3; ++col) {
        R35[row][col] = Rx4[row][0] * Ry5[0][col] + Rx4[row][1] * Ry5[1][col] + Rx4[row][2] * Ry5[2][col];
      }
    }
    for (int row = 0; row < 3; ++row) {
      for (int col = 0; col < 3; ++col) {
        R36[row][col] = R35[row][0] * Rx6[0][col] + R35[row][1] * Rx6[1][col] + R35[row][2] * Rx6[2][col];
      }
    }
    for (int row = 0; row < 3; ++row) {
      for (int col = 0; col < 3; ++col) {
        pose.R06[row][col] = R03[row][0] * R36[0][col] + R03[row][1] * R36[1][col] + R03[row][2] * R36[2][col];
      }
    }
    pose.valid = true;
}

bool solveTcp4Point(float tcpOut[3], float &rmsErrorMm) {
    for (int i = 0; i < 4; ++i) {
      if (!tcpCalPoses[i].valid) return false;
    }

    // Nine rows of (R_i - R_3) * t = p5_3 - p5_i, accumulated as normal equations.
    float normal[3][4] = {};
    for (int i = 0; i < 3; ++i) {
      for (int row = 0; row < 3; ++row) {
        float a[3];
        for (int col = 0; col < 3; ++col) {
          a[col] = tcpCalPoses[i].R06[row][col] - tcpCalPoses[3].R06[row][col];
        }
        const float b = tcpCalPoses[3].p5[row] - tcpCalPoses[i].p5[row];
        for (int col = 0; col < 3; ++col) {
          for (int k = 0; k < 3; ++k) normal[col][k] += a[col] * a[k];
          normal[col][3] += a[col] * b;
        }
      }
    }

    // Partial pivoting; reject pose sets with insufficient orientation diversity.
    float maxEntry = 0.0f;
    for (int row = 0; row < 3; ++row) {
      for (int col = 0; col < 3; ++col) maxEntry = fmaxf(maxEntry, fabsf(normal[row][col]));
    }
    if (maxEntry == 0.0f || !isfinite(maxEntry)) return false;
    for (int pivot = 0; pivot < 3; ++pivot) {
      int bestRow = pivot;
      for (int row = pivot + 1; row < 3; ++row) {
        if (fabsf(normal[row][pivot]) > fabsf(normal[bestRow][pivot])) bestRow = row;
      }
      if (fabsf(normal[bestRow][pivot]) <= maxEntry * 1.0e-6f) return false;
      if (bestRow != pivot) {
        for (int col = pivot; col < 4; ++col) {
          const float tmp = normal[pivot][col];
          normal[pivot][col] = normal[bestRow][col];
          normal[bestRow][col] = tmp;
        }
      }
      for (int row = pivot + 1; row < 3; ++row) {
        const float factor = normal[row][pivot] / normal[pivot][pivot];
        for (int col = pivot; col < 4; ++col) normal[row][col] -= factor * normal[pivot][col];
      }
    }

    float solution[3];
    for (int row = 2; row >= 0; --row) {
      float rhs = normal[row][3];
      for (int col = row + 1; col < 3; ++col) rhs -= normal[row][col] * solution[col];
      solution[row] = rhs / normal[row][row];
      if (!isfinite(solution[row])) return false;
    }

    // RMS of the four 3D TCP positions about their centroid, in millimetres.
    float tcpPositions[4][3], centroid[3] = {};
    for (int i = 0; i < 4; ++i) {
      for (int row = 0; row < 3; ++row) {
        float coordinate = tcpCalPoses[i].p5[row];
        for (int col = 0; col < 3; ++col) coordinate += tcpCalPoses[i].R06[row][col] * solution[col];
        tcpPositions[i][row] = coordinate;
        centroid[row] += coordinate * 0.25f;
      }
    }
    float squaredError = 0.0f;
    for (int i = 0; i < 4; ++i) {
      for (int row = 0; row < 3; ++row) {
        const float error = tcpPositions[i][row] - centroid[row];
        squaredError += error * error;
      }
    }
    const float rms = sqrtf(squaredError * 0.25f);
    if (!isfinite(rms)) return false;
    tcpOut[0] = solution[0] - TOOL_TOTAL_LEN;
    tcpOut[1] = solution[1];
    tcpOut[2] = solution[2];
    rmsErrorMm = rms;
    return true;
}

// ================= FORWARD KINEMATICS 6-DOF =================
void forwardKinematics6DOF(float j1_deg, float j2_deg, float j3_deg, float j4_deg, float j5_deg, float j6_deg,
                           float &x, float &y, float &z, float &roll_deg, float &pitch_deg, float &yaw_deg, bool raw) {
    float j1r = j1_deg * DEG_TO_RAD;
    float j2r = j2_deg * DEG_TO_RAD;
    float j3r = j3_deg * DEG_TO_RAD;
    float j4r = j4_deg * DEG_TO_RAD;
    float j5r = j5_deg * DEG_TO_RAD;
    float j6r = j6_deg * DEG_TO_RAD;

    float th1 = TH1_0 - j2r;
    float th2 = TH2_0 - (j2r + j3r);

    float j3_reach = L1 * sinf(th1);
    float j3_z     = BASE_H + L1 * cosf(th1);

    float j5_reach = j3_reach + L2 * sinf(th2);
    float j5_z     = j3_z + L2 * cosf(th2);

    float p5x = j5_reach * cosf(j1r);
    float p5y = j5_reach * sinf(j1r);
    float p5z = j5_z;

    // Pitch of tool at j4=0, j5=0 is TOOL_REST_ANGLE + (j2r + j3r) to harmonize with 3-DOF FK
    float pitch_base = TOOL_REST_ANGLE + (j2r + j3r);
    float c1 = cosf(j1r), s1 = sinf(j1r);
    float cp = cosf(pitch_base), sp = sinf(pitch_base);

    float R03[3][3] = {
      { c1 * cp, -s1, -c1 * sp },
      { s1 * cp,  c1, -s1 * sp },
      { sp,       0.0f, cp }
    };

    float c4 = cosf(j4r), s4 = sinf(j4r);
    float c5 = cosf(j5r), s5 = sinf(j5r);
    float c6 = cosf(j6r), s6 = sinf(j6r);

    float Rx4[3][3] = {
      { 1.0f,  0.0f,   0.0f },
      { 0.0f,    c4,    -s4 },
      { 0.0f,    s4,     c4 }
    };
    float Ry5[3][3] = {
      {   c5,  0.0f,    -s5 },
      { 0.0f,  1.0f,   0.0f },
      {   s5,  0.0f,     c5 }
    };
    float Rx6[3][3] = {
      { 1.0f,  0.0f,   0.0f },
      { 0.0f,    c6,    -s6 },
      { 0.0f,    s6,     c6 }
    };

    float R35[3][3];
    for(int i = 0; i < 3; ++i) {
      for(int j = 0; j < 3; ++j) {
        R35[i][j] = Rx4[i][0]*Ry5[0][j] + Rx4[i][1]*Ry5[1][j] + Rx4[i][2]*Ry5[2][j];
      }
    }
    float R36[3][3];
    for(int i = 0; i < 3; ++i) {
      for(int j = 0; j < 3; ++j) {
        R36[i][j] = R35[i][0]*Rx6[0][j] + R35[i][1]*Rx6[1][j] + R35[i][2]*Rx6[2][j];
      }
    }
    float R06[3][3];
    for(int i = 0; i < 3; ++i) {
      for(int j = 0; j < 3; ++j) {
        R06[i][j] = R03[i][0]*R36[0][j] + R03[i][1]*R36[1][j] + R03[i][2]*R36[2][j];
      }
    }

    const float t_local[3] = {
      TOOL_TOTAL_LEN + (raw ? 0.0f : toolOffset.x),
      raw ? 0.0f : toolOffset.y,
      raw ? 0.0f : toolOffset.z
    };
    x = p5x + R06[0][0] * t_local[0] + R06[0][1] * t_local[1] + R06[0][2] * t_local[2];
    y = p5y + R06[1][0] * t_local[0] + R06[1][1] * t_local[1] + R06[1][2] * t_local[2];
    z = p5z + R06[2][0] * t_local[0] + R06[2][1] * t_local[1] + R06[2][2] * t_local[2];

    if (!raw) {
        x += workOffset.x;  y += workOffset.y;  z += workOffset.z;
    }

    pitch_deg = atan2f(-R06[2][0], sqrtf(R06[0][0]*R06[0][0] + R06[1][0]*R06[1][0])) * RAD_TO_DEG;
    yaw_deg   = atan2f(R06[1][0], R06[0][0]) * RAD_TO_DEG;
    roll_deg  = atan2f(R06[2][1], R06[2][2]) * RAD_TO_DEG;
}

// ================= WORKSPACE CHECK =================
bool checkWorkspace(float j1, float j2, float j3, float j4, float j5, float j6) {
    if (j1 < LIMIT_J1_MIN || j1 > LIMIT_J1_MAX) return false;
    if (j2 < LIMIT_J2_MIN || j2 > LIMIT_J2_MAX) return false;
    if (j3 < LIMIT_J3_MIN || j3 > LIMIT_J3_MAX) return false;
    if (j4 < LIMIT_J4_MIN || j4 > LIMIT_J4_MAX) return false;
    if (j5 < LIMIT_J5_MIN || j5 > LIMIT_J5_MAX) return false;
    if (j6 < LIMIT_J6_MIN || j6 > LIMIT_J6_MAX) return false;

    float j2r = j2 * DEG_TO_RAD;
    float th1 = TH1_0 - j2r;
    float j3_z = BASE_H + L1 * cosf(th1);

    float tcp_x, tcp_y, tcp_z;
    forwardKinematics(j1, j2, j3, tcp_x, tcp_y, tcp_z, true, j4, j5, j6);

    if ((tcp_x * tcp_x + tcp_y * tcp_y) < EXCL_R2 && tcp_z < BASE_H) return false;

    if (j3_z < FLOOR_CLR) return false;
    if (tcp_z < FLOOR_CLR) return false;

    return true;
}

// ================= AR4-FORMAT RESPONSES =================
void sendRobotPos() {
  // Compute current FK position
  float cx, cy, cz;
  forwardKinematics(commandedAngle1, commandedAngle2, commandedAngle3, cx, cy, cz, false, commandedAngle4, commandedAngle5, commandedAngle6);
  float j4_val = constrain(commandedAngle4, LIMIT_J4_MIN, LIMIT_J4_MAX);
  float j5_val = constrain(commandedAngle5, LIMIT_J5_MIN, LIMIT_J5_MAX);
  float j6_val = constrain(commandedAngle6, LIMIT_J6_MIN, LIMIT_J6_MAX);

  Serial.print("A"); Serial.print(commandedAngle1, 3);
  Serial.print("B"); Serial.print(commandedAngle2, 3);
  Serial.print("C"); Serial.print(commandedAngle3, 3);
  Serial.print("D"); Serial.print(j4_val, 1);
  Serial.print("E"); Serial.print(j5_val, 1);
  Serial.print("F"); Serial.print(j6_val, 1);
  Serial.print("G"); Serial.print(cx, 2);
  Serial.print("H"); Serial.print(cy, 2);
  Serial.print("I"); Serial.println(cz, 2);
}

void sendACK() {
  Serial.println("OK");
}

void sendError(const char *code) {
  Serial.println(code);
}

// ================= ENCODER COLLISION DETECTION =================
void checkEncoders() {
  J1collisionTrue = 0;
  J2collisionTrue = 0;
  J3collisionTrue = 0;

  static uint8_t j1Violations = 0;
  static uint8_t j2Violations = 0;
  static uint8_t j3Violations = 0;

  auto getAngleError = [](float target, float actual) -> float {
    return fabsf(wrapAngleDeltaDeg(target - actual));
  };

  // J1 — Base (Wire2)
  if (encEnabled[0]) {
    uint16_t raw = readEncoderRetry(Wire2);
    if (raw != 0xFFFF) {
      float actual = getEncoderAngle(raw, enc1Offset);
      float error  = getAngleError(commandedAngle1, actual);
      if (error > COLLISION_THRESH_DEG) {
        if (++j1Violations >= 2) {
          J1collisionTrue = 1;
          Serial.print("COLLISION J1: err=");
          Serial.print(error, 1);
          Serial.println("deg");
        }
      } else {
        j1Violations = 0;
      }
    }
  }

  // J2 — Shoulder (Wire)
  if (encEnabled[1]) {
    uint16_t raw = readEncoderRetry(Wire);
    if (raw != 0xFFFF) {
      float actual = getEncoderAngle(raw, enc2Offset);
      float error  = getAngleError(commandedAngle2, actual);
      if (error > COLLISION_THRESH_DEG) {
        if (++j2Violations >= 2) {
          J2collisionTrue = 1;
          Serial.print("COLLISION J2: err=");
          Serial.print(error, 1);
          Serial.println("deg");
        }
      } else {
        j2Violations = 0;
      }
    }
  }

  // J3 — Elbow (Wire1)
  if (encEnabled[2]) {
    uint16_t raw = readEncoderRetry(Wire1);
    if (raw != 0xFFFF) {
      float actual = getEncoderAngle(raw, enc3Offset);
      float error  = getAngleError(commandedAngle3, actual);
      if (error > COLLISION_THRESH_DEG) {
        if (++j3Violations >= 2) {
          J3collisionTrue = 1;
          Serial.print("COLLISION J3: err=");
          Serial.print(error, 1);
          Serial.println("deg");
        }
      } else {
        j3Violations = 0;
      }
    }
  }

  // Build collision flag string (AR4 format: "EC000")
  int total = J1collisionTrue + J2collisionTrue + J3collisionTrue;
  if (total > 0) {
    // BUG-D FIX: stack-allocated buffer — replaces Arduino String heap alloc that fragments RAM
    char flag[16];
    snprintf(flag, sizeof(flag), "EC%d%d%d",
             J1collisionTrue, J2collisionTrue, J3collisionTrue);
    Serial.println(flag);
    if (!estopActive) {
      Serial.println("ERR: COLLISION DETECTED - Triggering ESTOP");
      parseCommand("ESTOP", 0);
    }
  }
}

// ================= IHOLD CURRENT MANAGEMENT =================
void applyHoldCurrent() {
  if (holdCurrentActive) return;
  holdCurrentActive = true;
}

void applyRunCurrent() {
  if (!holdCurrentActive) return;
  holdCurrentActive = false;
}

void applySpeedOverride() {
  // Main axes (J1-J6) AccelStepper limits set to physical limits for safe hold mode
  stepper1.setMaxSpeed(MAX_SPEED_J1);
  stepper2.setMaxSpeed(MAX_SPEED_J2);
  stepper3.setMaxSpeed(MAX_SPEED_J3);
  stepper4.setMaxSpeed(MAX_SPEED_J4);
  stepper5.setMaxSpeed(MAX_SPEED_J5);
  stepper6.setMaxSpeed(MAX_SPEED_J6);
  stepper1.setAcceleration(MAX_ACCEL_J1);
  stepper2.setAcceleration(MAX_ACCEL_J2);
  stepper3.setAcceleration(MAX_ACCEL_J3);
  stepper4.setAcceleration(MAX_ACCEL_J4);
  stepper5.setAcceleration(MAX_ACCEL_J5);
  stepper6.setAcceleration(MAX_ACCEL_J6);
}

// (Legacy blocking homeAxes removed in favor of startHoming/updateHoming state machine)
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
void loop() {
  unsigned long loopStart = micros();
  watchdog.feed();   // kick watchdog every loop
  myusb.Task();      // USB Host task

  // run/hold current switching — active during velocity-mode spline or holding
  bool anyRunning = (motionLoopActive && isMovingQueue) || streamMode ||
                    stepper1.isRunning() ||
                    stepper2.isRunning() ||
                    stepper3.isRunning() ||
                    stepper4.isRunning() ||
                    stepper5.isRunning() ||
                    stepper6.isRunning();
  if (anyRunning) applyRunCurrent();
  else            applyHoldCurrent();

  // --- ENCODER POLLING (50Hz non-blocking to prevent step pulse starvation) ---
  static unsigned long lastEncPollMs = 0;
  if (millis() - lastEncPollMs >= 20) {
    lastEncPollMs = millis();
    refreshEncoderCache();
  }

  // Process Inputs
  unsigned long inputStart = micros();
  processInput(Serial, inputBuffer, inputBufferPos, sizeof(inputBuffer));
  if (userial)
    processInput(userial, usbBuffer, usbBufferPos, sizeof(usbBuffer));
  processInput(Serial1, espBuffer, espBufferPos, sizeof(espBuffer));

  if (micros() - inputStart > MAX_INPUT_TIME_US) {
    Serial.println("WARN: Input processing slow");
  }

  // --- TELEMETRY STREAM (10Hz) ---
  static unsigned long lastTelem = 0;
  if (millis() - lastTelem >= 100) {
    lastTelem = millis();
    if (useTelemetry)     sendRobotPos();
    if (useJsonTelemetry) sendJSONTelemetry();
  }

  // Non-blocking homing state machine
  updateHoming();

  // Teach mode playback
  updateTeachPlayback();

  // --- EEPROM WRITE COALESCING (3-second debounce, only when idle) ---
  if (eepromDirty && !anyRunning && !isMovingQueue && (millis() - eepromDirtyTime >= EEPROM_DEBOUNCE_MS)) {
    eeprom_save_all();
    eepromDirty = false;
  }

  // --- CALIBRATION TEST RESULTS CHECK (deferred from ISR) ---
  if (calTestDone) {
    calTestDone = false;
    checkCalTestResults();
  }

  // --- WAYPOINT PROCESSING / HOLD / STREAM MODE ---
  if (homingState != HOMING_IDLE) {
    // Non-blocking homing active: stepper motors driven exclusively by updateHoming()
  } else if (motionLoopActive && isMovingQueue) {
    // Speeds and pulses generated by ISRs
  } else {
    // ── HOLD / STREAM MODE ──
    if (streamMode) {
      if (lastStreamMicros == 0) lastStreamMicros = micros();
      unsigned long nowUs = micros();
      float dt = (nowUs - lastStreamMicros) / 1000000.0f;
      lastStreamMicros = nowUs;
      if (dt > 0.05f) dt = 0.05f;

      // Acceleration limit (deg/s^2) safely within TMC2209 torque limits
      float maxAcc = 140.0f;
      float effectiveOverride = speedOverride;
      if (currentOpMode == OpMode::T1_MANUAL_REDUCED && effectiveOverride > 0.15f)
        effectiveOverride = 0.15f;

      auto updateTracking = [&](float target, volatile float &pos, float &vel, float maxVel) {
        float error = target - pos;
        if (fabsf(error) < 0.005f && fabsf(vel) < 0.05f) {
          pos = target;
          vel = 0.0f;
          return;
        }

        float sgn = (error > 0.0f) ? 1.0f : -1.0f;
        float absErr = fabsf(error);
        float targetSpeed = sgn * sqrtf(2.0f * maxAcc * absErr);
        targetSpeed = constrain(targetSpeed, -maxVel, maxVel);

        float maxVelDelta = maxAcc * dt;
        vel = constrain(targetSpeed, vel - maxVelDelta, vel + maxVelDelta);
        vel = constrain(vel, -maxVel, maxVel);
        pos += vel * dt;
      };

      updateTracking(streamTargetJ1, commandedAngle1, streamVelJ1, MAX_SPEED_J1 * effectiveOverride / stepsPerDegAxis1);
      updateTracking(streamTargetJ2, commandedAngle2, streamVelJ2, MAX_SPEED_J2 * effectiveOverride / stepsPerDegGeared);
      updateTracking(streamTargetJ3, commandedAngle3, streamVelJ3, MAX_SPEED_J3 * effectiveOverride / stepsPerDegGeared);
      updateTracking(streamTargetJ4, commandedAngle4, streamVelJ4, MAX_SPEED_J4 * effectiveOverride / stepsPerDegAxis4);
      updateTracking(streamTargetJ5, commandedAngle5, streamVelJ5, MAX_SPEED_J5 * effectiveOverride / stepsPerDegAxis5);
      updateTracking(streamTargetJ6, commandedAngle6, streamVelJ6, MAX_SPEED_J6 * effectiveOverride / stepsPerDegAxis6);

      applyBacklashComp(0, streamVelJ1 * dt);
      applyBacklashComp(1, streamVelJ2 * dt);
      applyBacklashComp(2, streamVelJ3 * dt);
      applyBacklashComp(3, streamVelJ4 * dt);
      applyBacklashComp(4, streamVelJ5 * dt);
      applyBacklashComp(5, streamVelJ6 * dt);

      const float p1 = useEncoders && jointEnabled[0] && encEnabled[0] ? pidAdj1 : 0.0f;
      const float p2 = useEncoders && jointEnabled[1] && encEnabled[1] ? pidAdj2 : 0.0f;
      const float p3 = useEncoders && jointEnabled[2] && encEnabled[2] ? pidAdj3 : 0.0f;
      const float kPosTrack = 15.0f;
      const float desSteps1 = (commandedAngle1 + p1) * stepsPerDegAxis1 + backlashOffsetSteps[0];
      const float desSteps2 = (commandedAngle2 + p2) * stepsPerDegGeared + backlashOffsetSteps[1];
      const float desSteps3 = (commandedAngle3 + p3) * stepsPerDegGeared * J3_STEP_SIGN + backlashOffsetSteps[2];
      const float desSteps4 = commandedAngle4 * stepsPerDegAxis4 + backlashOffsetSteps[3];
      const float desSteps5 = commandedAngle5 * stepsPerDegAxis5 + backlashOffsetSteps[4];
      const float desSteps6 = commandedAngle6 * stepsPerDegAxis6 + backlashOffsetSteps[5];

      const float spd1 = constrain(streamVelJ1 * stepsPerDegAxis1 + kPosTrack * (desSteps1 - stepper1.currentPosition()), -MAX_SPEED_J1 * effectiveOverride, MAX_SPEED_J1 * effectiveOverride);
      const float spd2 = constrain(streamVelJ2 * stepsPerDegGeared + kPosTrack * (desSteps2 - stepper2.currentPosition()), -MAX_SPEED_J2 * effectiveOverride, MAX_SPEED_J2 * effectiveOverride);
      const float spd3 = constrain(streamVelJ3 * stepsPerDegGeared * J3_STEP_SIGN + kPosTrack * (desSteps3 - stepper3.currentPosition()), -MAX_SPEED_J3 * effectiveOverride, MAX_SPEED_J3 * effectiveOverride);
      const float spd4 = constrain(streamVelJ4 * stepsPerDegAxis4 + kPosTrack * (desSteps4 - stepper4.currentPosition()), -MAX_SPEED_J4 * effectiveOverride, MAX_SPEED_J4 * effectiveOverride);
      const float spd5 = constrain(streamVelJ5 * stepsPerDegAxis5 + kPosTrack * (desSteps5 - stepper5.currentPosition()), -MAX_SPEED_J5 * effectiveOverride, MAX_SPEED_J5 * effectiveOverride);
      const float spd6 = constrain(streamVelJ6 * stepsPerDegAxis6 + kPosTrack * (desSteps6 - stepper6.currentPosition()), -MAX_SPEED_J6 * effectiveOverride, MAX_SPEED_J6 * effectiveOverride);
      setStepperSpeedDDA(0, stepper1, spd1);
      setStepperSpeedDDA(1, stepper2, spd2);
      setStepperSpeedDDA(2, stepper3, spd3);
      setStepperSpeedDDA(3, stepper4, spd4);
      setStepperSpeedDDA(4, stepper5, spd5);
      setStepperSpeedDDA(5, stepper6, spd6);

      if (millis() - streamLastUpdateMs > STREAM_TIMEOUT_MS) {
        stopStreamMode(true);
      }
    } else {
      float p1 = useEncoders && jointEnabled[0] && encEnabled[0] ? pidAdj1 : 0.0f;
      float p2 = useEncoders && jointEnabled[1] && encEnabled[1] ? pidAdj2 : 0.0f;
      float p3 = useEncoders && jointEnabled[2] && encEnabled[2] ? pidAdj3 : 0.0f;

      long tgt1 = (long)roundf((commandedAngle1 + p1) * stepsPerDegAxis1) + (long)backlashOffsetSteps[0];
      long tgt2 = (long)roundf((commandedAngle2 + p2) * stepsPerDegGeared) + (long)backlashOffsetSteps[1];
      long tgt3 = j3AngleToSteps(commandedAngle3 + p3) + (long)backlashOffsetSteps[2];
      long tgt4 = j4AngleToSteps(commandedAngle4) + (long)backlashOffsetSteps[3];
      long tgt5 = j5AngleToSteps(commandedAngle5) + (long)backlashOffsetSteps[4];
      long tgt6 = j6AngleToSteps(commandedAngle6) + (long)backlashOffsetSteps[5];

      noInterrupts();
      if (tgt1 != stepper1.targetPosition()) stepper1.moveTo(tgt1);
      if (tgt2 != stepper2.targetPosition()) stepper2.moveTo(tgt2);
      if (tgt3 != stepper3.targetPosition()) stepper3.moveTo(tgt3);
      if (tgt4 != stepper4.targetPosition()) stepper4.moveTo(tgt4);
      if (tgt5 != stepper5.targetPosition()) stepper5.moveTo(tgt5);
      if (tgt6 != stepper6.targetPosition()) stepper6.moveTo(tgt6);
      interrupts();
    }
  }

  // ── Post-move encoder collision check with 100ms settling time ─────────────────
  static bool wasRunning = false;
  static unsigned long stopTimestamp = 0;
  static bool checkPending = false;
  if (wasRunning && !anyRunning) {   // just stopped
    stopTimestamp = millis();
    checkPending = true;
  }
  wasRunning = anyRunning;

  if (checkPending && !anyRunning && (millis() - stopTimestamp >= 100)) {
    checkPending = false;
    checkEncoders();
    sendRobotPos();                  // AR4-style position reply
  }

  // Loop Timing Check (rate-limited to 1Hz warning to prevent serial spam)
  static unsigned long lastOverrunWarn = 0;
  if (micros() - loopStart > MAX_LOOP_TIME_US) {
    if (millis() - lastOverrunWarn >= 1000) {
      lastOverrunWarn = millis();
      Serial.print("WARN: Loop overrun: ");
      Serial.println(micros() - loopStart);
    }
  }
}

// ================= IK — Analytical 2-Link Planar =================
void calculateIK(float x, float y, float z, unsigned long duration,
                 WristMode wristMode, float j4_manual_deg, float j5_deg, bool isMovL, float j6_deg) {
    x -= workOffset.x;  y -= workOffset.y;  z -= workOffset.z;

    Serial.print("IK Target: X="); Serial.print(x);
    Serial.print(" Y="); Serial.print(y);
    Serial.print(" Z="); Serial.println(z);

    // 1. J1 — rotation in XY plane
    float theta1 = atan2f(y, x);
    float deg1 = theta1 * RAD_TO_DEG;

    // 2. Horizontal reach from J1 axis
    float r = sqrtf(x*x + y*y);

    bool was_clamped = false;
    // Floor collision clamp
    if (z < FLOOR_CLR) {
        z = FLOOR_CLR;
        was_clamped = true;
    }
    // Base exclusion zone clamp
    if (r*r < EXCL_R2 && z < BASE_H) {
        r = sqrtf(EXCL_R2);
        was_clamped = true;
    }

    // 3. Decouple Wrist Center J5 based on wrist orientation
    const float effToolLen = TOOL_TOTAL_LEN + toolOffset.x;
    float r5 = r;
    float z5 = z;
    if (wristMode == WristMode::DOWN_0 || wristMode == WristMode::DOWN_90 || wristMode == WristMode::PITCH_90) {
        z5 = z + effToolLen;
    } else if (wristMode == WristMode::PITCH_180) {
        z5 = z - effToolLen;
    } else if (wristMode == WristMode::MANUAL) {
        float pitch_rad = j4_manual_deg * DEG_TO_RAD;
        r5 = fmaxf(0.0f, r - effToolLen * cosf(pitch_rad));
        z5 = z - effToolLen * sinf(pitch_rad);
    } else {
        r5 = fmaxf(0.0f, r - effToolLen);
    }

    float dr = r5;
    float dz = z5 - BASE_H;
    float D2 = dr*dr + dz*dz;
    float D = sqrtf(D2);

    float C_gamma = (L1*L1 + L2*L2 - D2) / (2.0f * L1 * L2);
    if (C_gamma < -1.0f) { C_gamma = -1.0f; was_clamped = true; }
    if (C_gamma >  1.0f) { C_gamma =  1.0f; was_clamped = true; }

    float gamma = acosf(C_gamma);
    float j3_1_deg = (gamma - GAMMA_0) * RAD_TO_DEG;
    float j3_2_deg = (-gamma - GAMMA_0) * RAD_TO_DEG;

    float beta = atan2f(dr, dz);
    float C_alpha = (L1*L1 + D2 - L2*L2) / (2.0f * L1 * fmaxf(1e-6f, D));
    C_alpha = fmaxf(-1.0f, fminf(1.0f, C_alpha));
    float alpha = acosf(C_alpha);

    float j2_1_deg = (TH1_0 - (beta - alpha)) * RAD_TO_DEG;
    float j2_2_deg = (TH1_0 - (beta + alpha)) * RAD_TO_DEG;

    // Joint limit clamping
    if (deg1 < LIMIT_J1_MIN) { deg1 = LIMIT_J1_MIN; was_clamped = true; }
    if (deg1 > LIMIT_J1_MAX) { deg1 = LIMIT_J1_MAX; was_clamped = true; }

    auto clampJ = [](float j, float minJ, float maxJ, bool &clamped) {
        if (j < minJ) { clamped = true; return minJ; }
        if (j > maxJ) { clamped = true; return maxJ; }
        return j;
    };

    bool sol1_clamped = was_clamped;
    float c_j2_1 = clampJ(j2_1_deg, LIMIT_J2_MIN, LIMIT_J2_MAX, sol1_clamped);
    float c_j3_1 = clampJ(j3_1_deg, LIMIT_J3_MIN, LIMIT_J3_MAX, sol1_clamped);

    bool sol2_clamped = was_clamped;
    float c_j2_2 = clampJ(j2_2_deg, LIMIT_J2_MIN, LIMIT_J2_MAX, sol2_clamped);
    float c_j3_2 = clampJ(j3_2_deg, LIMIT_J3_MIN, LIMIT_J3_MAX, sol2_clamped);

    bool sol1_valid = checkWorkspace(deg1, c_j2_1, c_j3_1, 0.0f, 0.0f, 0.0f);
    bool sol2_valid = checkWorkspace(deg1, c_j2_2, c_j3_2, 0.0f, 0.0f, 0.0f);

    float best_j2 = 0, best_j3 = 0;
    bool found_solution = false;

    if (sol1_valid && sol2_valid) {
        float d1 = fabsf(c_j2_1 - commandedAngle2) + fabsf(c_j3_1 - commandedAngle3);
        float d2 = fabsf(c_j2_2 - commandedAngle2) + fabsf(c_j3_2 - commandedAngle3);
        if (d1 < d2) {
            best_j2 = c_j2_1; best_j3 = c_j3_1; was_clamped = sol1_clamped;
        } else {
            best_j2 = c_j2_2; best_j3 = c_j3_2; was_clamped = sol2_clamped;
        }
        found_solution = true;
    } else if (sol1_valid) {
        best_j2 = c_j2_1; best_j3 = c_j3_1; was_clamped = sol1_clamped;
        found_solution = true;
    } else if (sol2_valid) {
        best_j2 = c_j2_2; best_j3 = c_j3_2; was_clamped = sol2_clamped;
        found_solution = true;
    }

    if (!found_solution) {
        Serial.println("ERR:WORKSPACE_VIOLATION");
        return;
    }

    if (was_clamped) {
        Serial.println("WARN: Out of workspace - clamped to closest valid");
    }

    Serial.print("IK Solution: J1="); Serial.print(deg1,2);
    Serial.print(" J2="); Serial.print(best_j2,2);
    Serial.print(" J3="); Serial.println(best_j3,2);

    // Wrist J4, J5, J6 computation matching RobotKinematics.js
    float ang34_deg = best_j2 + best_j3;
    float calc_j4 = 0.0f, calc_j5 = 0.0f, calc_j6 = j6_deg;
    const float basePitchOffsetDeg = -(TOOL_REST_ANGLE * RAD_TO_DEG);

    switch (wristMode) {
        case WristMode::LEVEL:
            calc_j4 = 0.0f;
            calc_j5 = basePitchOffsetDeg - ang34_deg;
            calc_j6 = 0.0f;
            break;
        case WristMode::DOWN_0:
            calc_j4 = 0.0f;
            calc_j5 = basePitchOffsetDeg - ang34_deg - 90.0f;
            calc_j6 = 0.0f;
            break;
        case WristMode::DOWN_90:
            calc_j4 = 0.0f;
            calc_j5 = basePitchOffsetDeg - ang34_deg - 90.0f;
            calc_j6 = 90.0f;
            break;
        case WristMode::PITCH_0:
            calc_j4 = 0.0f;
            calc_j5 = basePitchOffsetDeg - ang34_deg;
            calc_j6 = j6_deg;
            break;
        case WristMode::PITCH_90:
            calc_j4 = 0.0f;
            calc_j5 = basePitchOffsetDeg - ang34_deg - 90.0f;
            calc_j6 = j6_deg;
            break;
        case WristMode::PITCH_180:
            calc_j4 = 0.0f;
            calc_j5 = basePitchOffsetDeg - ang34_deg + 90.0f;
            calc_j6 = j6_deg;
            break;
        case WristMode::MANUAL:
        default:
            calc_j4 = j4_manual_deg;
            calc_j5 = j5_deg - (TOOL_REST_ANGLE * RAD_TO_DEG) - ang34_deg;
            calc_j6 = j6_deg;
            break;
    }

    calc_j4 = constrain(calc_j4, LIMIT_J4_MIN, LIMIT_J4_MAX);
    calc_j5 = constrain(calc_j5, LIMIT_J5_MIN, LIMIT_J5_MAX);
    calc_j6 = constrain(calc_j6, LIMIT_J6_MIN, LIMIT_J6_MAX);

    if (!checkWorkspace(deg1, best_j2, best_j3, calc_j4, calc_j5, calc_j6)) {
        Serial.println("ERR:WORKSPACE_VIOLATION (wrist)");
        return;
    }

    Serial.print("  Wrist W"); Serial.print(static_cast<uint8_t>(wristMode));
    Serial.print(" J4="); Serial.print(calc_j4,1);
    Serial.print("deg J5="); Serial.print(calc_j5,1);
    Serial.print("deg J6="); Serial.print(calc_j6,1); Serial.println("deg");

    moveToAngles(deg1, best_j2, best_j3, duration, false, calc_j4, calc_j5, isMovL, calc_j6);
}

// ================= 6-DOF INVERSE KINEMATICS WITH SINGULARITY DAMPENING =================
void calculateIK6DOF(float x, float y, float z, float roll_deg, float pitch_deg, float yaw_deg,
                     unsigned long duration, bool isMovL) {
    x -= workOffset.x;  y -= workOffset.y;  z -= workOffset.z;

    Serial.print("IK6DOF Target: X="); Serial.print(x);
    Serial.print(" Y="); Serial.print(y);
    Serial.print(" Z="); Serial.print(z);
    Serial.print(" R="); Serial.print(roll_deg);
    Serial.print(" P="); Serial.print(pitch_deg);
    Serial.print(" YW="); Serial.println(yaw_deg);

    float r = roll_deg * DEG_TO_RAD;
    float p = pitch_deg * DEG_TO_RAD;
    float yw = yaw_deg * DEG_TO_RAD;

    float cr = cosf(r), sr = sinf(r);
    float cp = cosf(p), sp = sinf(p);
    float cy = cosf(yw), sy = sinf(yw);

    // R06 = Rz(yaw) * Ry(pitch) * Rx(roll)
    float R06[3][3] = {
      { cy * cp, cy * sp * sr - sy * cr, cy * sp * cr + sy * sr },
      { sy * cp, sy * sp * sr + cy * cr, sy * sp * cr - cy * sr },
      { -sp,     cp * sr,                cp * cr }
    };

    // 1. Decouple Wrist Center P5
    const float t_local[3] = { TOOL_TOTAL_LEN + toolOffset.x, toolOffset.y, toolOffset.z };
    float x5 = x - (R06[0][0] * t_local[0] + R06[0][1] * t_local[1] + R06[0][2] * t_local[2]);
    float y5 = y - (R06[1][0] * t_local[0] + R06[1][1] * t_local[1] + R06[1][2] * t_local[2]);
    float z5 = z - (R06[2][0] * t_local[0] + R06[2][1] * t_local[1] + R06[2][2] * t_local[2]);

    // 2. Base J1 (Shoulder singularity damping when r5 ~ 0)
    float r5 = sqrtf(x5 * x5 + y5 * y5);
    float deg1 = (r5 < 0.5f) ? commandedAngle1 : (atan2f(y5, x5) * RAD_TO_DEG);

    bool was_clamped = false;
    float zc = z5;
    if (zc < FLOOR_CLR) {
        zc = FLOOR_CLR;
        was_clamped = true;
    }
    float rc = r5;
    if (rc * rc < EXCL_R2 && zc < BASE_H) {
        rc = sqrtf(EXCL_R2);
        was_clamped = true;
    }

    // 3. Planar 2-Link IK for J2, J3
    float dr = rc;
    float dz = zc - BASE_H;
    float D2 = dr * dr + dz * dz;
    float D = sqrtf(D2);

    // Reach boundary singularity dampening
    const float maxReach = L1 + L2;
    if (D > maxReach * 0.999f) {
        D = maxReach * 0.999f;
        D2 = D * D;
        was_clamped = true;
    }

    float C_gamma = (L1 * L1 + L2 * L2 - D2) / (2.0f * L1 * L2);
    C_gamma = fmaxf(-1.0f, fminf(1.0f, C_gamma));
    float gamma = acosf(C_gamma);

    float beta = atan2f(dr, dz);
    float C_alpha = (L1 * L1 + D2 - L2 * L2) / (2.0f * L1 * fmaxf(1e-6f, D));
    C_alpha = fmaxf(-1.0f, fminf(1.0f, C_alpha));
    float alpha = acosf(C_alpha);

    float cand1_j2 = (TH1_0 - (beta - alpha)) * RAD_TO_DEG;
    float cand1_j3 = (gamma - GAMMA_0) * RAD_TO_DEG;

    float cand2_j2 = (TH1_0 - (beta + alpha)) * RAD_TO_DEG;
    float cand2_j3 = (-gamma - GAMMA_0) * RAD_TO_DEG;

    auto clampJ = [](float j, float minJ, float maxJ, bool &clamped) {
        if (j < minJ) { clamped = true; return minJ; }
        if (j > maxJ) { clamped = true; return maxJ; }
        return j;
    };

    if (deg1 < LIMIT_J1_MIN) { deg1 = LIMIT_J1_MIN; was_clamped = true; }
    if (deg1 > LIMIT_J1_MAX) { deg1 = LIMIT_J1_MAX; was_clamped = true; }

    bool sol1_clamped = was_clamped;
    float c_j2_1 = clampJ(cand1_j2, LIMIT_J2_MIN, LIMIT_J2_MAX, sol1_clamped);
    float c_j3_1 = clampJ(cand1_j3, LIMIT_J3_MIN, LIMIT_J3_MAX, sol1_clamped);

    bool sol2_clamped = was_clamped;
    float c_j2_2 = clampJ(cand2_j2, LIMIT_J2_MIN, LIMIT_J2_MAX, sol2_clamped);
    float c_j3_2 = clampJ(cand2_j3, LIMIT_J3_MIN, LIMIT_J3_MAX, sol2_clamped);

    bool sol1_valid = checkWorkspace(deg1, c_j2_1, c_j3_1, 0.0f, 0.0f, 0.0f);
    bool sol2_valid = checkWorkspace(deg1, c_j2_2, c_j3_2, 0.0f, 0.0f, 0.0f);

    float best_j2 = 0.0f, best_j3 = 0.0f;
    bool found_solution = false;

    if (sol1_valid && sol2_valid) {
        float d1 = fabsf(c_j2_1 - commandedAngle2) + fabsf(c_j3_1 - commandedAngle3);
        float d2 = fabsf(c_j2_2 - commandedAngle2) + fabsf(c_j3_2 - commandedAngle3);
        if (d1 < d2) {
            best_j2 = c_j2_1; best_j3 = c_j3_1; was_clamped = sol1_clamped;
        } else {
            best_j2 = c_j2_2; best_j3 = c_j3_2; was_clamped = sol2_clamped;
        }
        found_solution = true;
    } else if (sol1_valid) {
        best_j2 = c_j2_1; best_j3 = c_j3_1; was_clamped = sol1_clamped;
        found_solution = true;
    } else if (sol2_valid) {
        best_j2 = c_j2_2; best_j3 = c_j3_2; was_clamped = sol2_clamped;
        found_solution = true;
    }

    if (!found_solution) {
        Serial.println("ERR:WORKSPACE_VIOLATION");
        return;
    }

    // 4. Forearm Frame R03 — harmonized with forwardKinematics6DOF()
    float j1r = deg1 * DEG_TO_RAD;
    float j2r = best_j2 * DEG_TO_RAD;
    float j3r = best_j3 * DEG_TO_RAD;
    float pitch_base = TOOL_REST_ANGLE + (j2r + j3r);

    float c1_ = cosf(j1r), s1_ = sinf(j1r);
    float cp_ = cosf(pitch_base), sp_ = sinf(pitch_base);

    float R03[3][3] = {
      { c1_ * cp_, -s1_, -c1_ * sp_ },
      { s1_ * cp_,  c1_, -s1_ * sp_ },
      { sp_,       0.0f,  cp_ }
    };

    // 5. Wrist Rotation Matrix: R36 = R03^T * R06
    float R36[3][3];
    for (int i = 0; i < 3; ++i) {
      for (int j = 0; j < 3; ++j) {
        R36[i][j] = R03[0][i] * R06[0][j] + R03[1][i] * R06[1][j] + R03[2][i] * R06[2][j];
      }
    }

    // Decompose R36 = Rx(j4) * Ry(-j5) * Rx(j6) with smooth singularity blending
    //   R36[0][0] = c5          R36[0][1] = -s5*s6   R36[0][2] = -s5*c6
    //   R36[1][0] = -s4*s5      R36[2][0] =  c4*s5
    float cosJ5 = fmaxf(-1.0f, fminf(1.0f, R36[0][0]));
    float sinJ5_sq = R36[1][0] * R36[1][0] + R36[2][0] * R36[2][0];
    float sinJ5 = sqrtf(sinJ5_sq);

    float calc_j4, calc_j5, calc_j6;
    const float SING_ZONE_SIN = 0.1736f; // sin(10 deg): start of singularity blend zone

    // Branch 1: sin(j5) > 0
    float j5_1 = atan2f(sinJ5, cosJ5) * RAD_TO_DEG;
    float j4_1 = atan2f(-R36[1][0], R36[2][0]) * RAD_TO_DEG;
    float j6_1 = atan2f(-R36[0][1], -R36[0][2]) * RAD_TO_DEG;

    // Branch 2: sin(j5) < 0
    float j5_2 = atan2f(-sinJ5, cosJ5) * RAD_TO_DEG;
    float j4_2 = atan2f(R36[1][0], -R36[2][0]) * RAD_TO_DEG;
    float j6_2 = atan2f(R36[0][1], R36[0][2]) * RAD_TO_DEG;

    bool b1_valid = (j4_1 >= LIMIT_J4_MIN - 0.01f && j4_1 <= LIMIT_J4_MAX + 0.01f &&
                     j5_1 >= LIMIT_J5_MIN - 0.01f && j5_1 <= LIMIT_J5_MAX + 0.01f &&
                     j6_1 >= LIMIT_J6_MIN - 0.01f && j6_1 <= LIMIT_J6_MAX + 0.01f);
    bool b2_valid = (j4_2 >= LIMIT_J4_MIN - 0.01f && j4_2 <= LIMIT_J4_MAX + 0.01f &&
                     j5_2 >= LIMIT_J5_MIN - 0.01f && j5_2 <= LIMIT_J5_MAX + 0.01f &&
                     j6_2 >= LIMIT_J6_MIN - 0.01f && j6_2 <= LIMIT_J6_MAX + 0.01f);

    // Pick the valid branch closest to the current pose (shortest wrapped angular distance)
    float dist1 = fabsf(wrapAngleDeltaDeg(j4_1 - commandedAngle4)) +
                  fabsf(wrapAngleDeltaDeg(j5_1 - commandedAngle5)) +
                  fabsf(wrapAngleDeltaDeg(j6_1 - commandedAngle6));
    float dist2 = fabsf(wrapAngleDeltaDeg(j4_2 - commandedAngle4)) +
                  fabsf(wrapAngleDeltaDeg(j5_2 - commandedAngle5)) +
                  fabsf(wrapAngleDeltaDeg(j6_2 - commandedAngle6));

    bool useBranch2;
    if (b1_valid && !b2_valid)      useBranch2 = false;
    else if (b2_valid && !b1_valid) useBranch2 = true;
    else                            useBranch2 = (dist2 < dist1);

    float raw_j4 = useBranch2 ? j4_2 : j4_1;
    float raw_j5 = useBranch2 ? j5_2 : j5_1;
    float raw_j6 = useBranch2 ? j6_2 : j6_1;

    if (sinJ5 < SING_ZONE_SIN) {
        // Near wrist singularity: J4 and J6 become collinear. Blend smoothly (Hermite)
        // from "hold J4, put all roll into J6" (w=0) to the raw solution (w=1).
        float u = constrain(sinJ5 / SING_ZONE_SIN, 0.0f, 1.0f);
        float w = u * u * (3.0f - 2.0f * u);

        calc_j5 = raw_j5;
        calc_j4 = commandedAngle4 + w * wrapAngleDeltaDeg(raw_j4 - commandedAngle4);

        float totalRoll, sing_j6;
        if (cosJ5 >= 0.0f) {
            totalRoll = atan2f(R36[2][1] - R36[1][2], R36[1][1] + R36[2][2]) * RAD_TO_DEG;
            sing_j6 = wrapAngleDeltaDeg(totalRoll - calc_j4);
        } else {
            totalRoll = atan2f(R36[1][2] + R36[2][1], R36[1][1] - R36[2][2]) * RAD_TO_DEG;
            sing_j6 = wrapAngleDeltaDeg(calc_j4 - totalRoll);
        }
        calc_j6 = sing_j6 + w * wrapAngleDeltaDeg(raw_j6 - sing_j6);
    } else {
        calc_j4 = raw_j4;
        calc_j5 = raw_j5;
        calc_j6 = raw_j6;
    }

    calc_j4 = clampJ(calc_j4, LIMIT_J4_MIN, LIMIT_J4_MAX, was_clamped);
    calc_j5 = clampJ(calc_j5, LIMIT_J5_MIN, LIMIT_J5_MAX, was_clamped);
    calc_j6 = clampJ(calc_j6, LIMIT_J6_MIN, LIMIT_J6_MAX, was_clamped);

    if (!checkWorkspace(deg1, best_j2, best_j3, calc_j4, calc_j5, calc_j6)) {
        Serial.println("ERR:WORKSPACE_VIOLATION (wrist)");
        return;
    }

    if (was_clamped) {
        Serial.println("WARN: Out of workspace - clamped to closest valid");
    }

    Serial.print("IK6DOF Solution: J1="); Serial.print(deg1, 2);
    Serial.print(" J2="); Serial.print(best_j2, 2);
    Serial.print(" J3="); Serial.print(best_j3, 2);
    Serial.print(" J4="); Serial.print(calc_j4, 2);
    Serial.print(" J5="); Serial.print(calc_j5, 2);
    Serial.print(" J6="); Serial.println(calc_j6, 2);

    moveToAngles(deg1, best_j2, best_j3, duration, false, calc_j4, calc_j5, isMovL, calc_j6);
}

void moveToAngles(float t1, float t2, float t3, unsigned long duration_ms,
                  bool skipWorkspaceCheck, float t4, float t5, bool isMovL, float t6) {
    if (estopActive) {
        Serial.println("ERR: Motion rejected - ESTOP is active");
        return;
    }
    if (controlledStopReq) {
        Serial.println("ERR: Motion rejected - controlled stop in progress");
        return;
    }
    t1 = constrain(t1, LIMIT_J1_MIN, LIMIT_J1_MAX);
    t2 = constrain(t2, LIMIT_J2_MIN, LIMIT_J2_MAX);
    t3 = constrain(t3, LIMIT_J3_MIN, LIMIT_J3_MAX);

    float cur_t4 = (t4 >= -998.0f) ? constrain(t4, LIMIT_J4_MIN, LIMIT_J4_MAX) : commandedAngle4;
    float cur_t5 = (t5 >= -998.0f) ? constrain(t5, LIMIT_J5_MIN, LIMIT_J5_MAX) : commandedAngle5;
    float cur_t6 = (t6 >= -998.0f) ? constrain(t6, LIMIT_J6_MIN, LIMIT_J6_MAX) : commandedAngle6;

    if (!skipWorkspaceCheck) {
        if (!checkWorkspace(t1, t2, t3, cur_t4, cur_t5, cur_t6)) {
            Serial.println("ERR:WORKSPACE_VIOLATION");
            return;
        }
    }

    if (duration_ms == 0) {
        // Activate critically damped live stream mode (bypasses spline queue)
        streamTargetJ1 = t1;
        streamTargetJ2 = t2;
        streamTargetJ3 = t3;
        streamTargetJ4 = cur_t4;
        streamTargetJ5 = cur_t5;
        streamTargetJ6 = cur_t6;
        streamLastUpdateMs = millis();
        if (!streamMode) {
            streamVelJ1 = streamVelJ2 = streamVelJ3 = streamVelJ4 = streamVelJ5 = streamVelJ6 = 0.0f;
            lastStreamMicros = 0;
            streamMode = true;
        }
        qHead = qTail;
        isMovingQueue = false;
        wasContinuous = false;
        motionLoopActive = false;
        return;
    }

    // Any standard queued waypoint MUST cancel live stream mode
    if (streamMode) stopStreamMode(false);

    noInterrupts();
    uint8_t nextHead = (qHead + 1) % WAYPOINT_QUEUE_SIZE;
    if (nextHead == qTail) {
        if (isMovL) {
            interrupts();
            while ( ((volatile uint8_t)qHead + 1) % WAYPOINT_QUEUE_SIZE == (volatile uint8_t)qTail ) {
                if (estopActive) break;
                watchdog.feed();
                myusb.Task();
                delayMicroseconds(500);
            }
            noInterrupts();
            nextHead = (qHead + 1) % WAYPOINT_QUEUE_SIZE;
        } else {
            uint8_t lastSlot = (qHead > 0) ? (qHead - 1) : (WAYPOINT_QUEUE_SIZE - 1);
            motionQueue[lastSlot] = { t1, t2, t3, cur_t4, cur_t5, cur_t6, duration_ms };
            interrupts();
            return;
        }
    }

    // Enqueue waypoint into FIFO lookahead buffer
    motionQueue[qHead] = { t1, t2, t3, cur_t4, cur_t5, cur_t6, duration_ms };
    qHead = nextHead;
    motionLoopActive = true;
    interrupts();
}

// ================= SIMPLE CONTROL COMMANDS =================

// REFACTOR R-1: wspólna funkcja dla D1/D2/D3 — eliminuje 3 identyczne bloki.
// Poprzednio każda oś miała 10-liniowy kopipejst różniący się tylko numerem.
static void handleStreamJog(int axis, float delta) {
  if (axis < 1 || axis > 6) return;
  if (controlledStopReq) {
    Serial.println("ERR: Jog rejected - controlled stop in progress");
    return;
  }
  if (!jointEnabled[axis - 1]) {
    Serial.printf("WARN: J%d disabled\n", axis);
    return;
  }

  if (!streamMode) {
    streamVelJ1 = streamVelJ2 = streamVelJ3 = streamVelJ4 = streamVelJ5 = streamVelJ6 = 0.0f;
    lastStreamMicros = 0;
  }

  float current, limitMin, limitMax;
  switch (axis) {
    case 1: current = commandedAngle1; limitMin = LIMIT_J1_MIN; limitMax = LIMIT_J1_MAX; break;
    case 2: current = commandedAngle2; limitMin = LIMIT_J2_MIN; limitMax = LIMIT_J2_MAX; break;
    case 3: current = commandedAngle3; limitMin = LIMIT_J3_MIN; limitMax = LIMIT_J3_MAX; break;
    case 4: current = commandedAngle4; limitMin = LIMIT_J4_MIN; limitMax = LIMIT_J4_MAX; break;
    case 5: current = commandedAngle5; limitMin = LIMIT_J5_MIN; limitMax = LIMIT_J5_MAX; break;
    default: current = commandedAngle6; limitMin = LIMIT_J6_MIN; limitMax = LIMIT_J6_MAX; break;
  }

  float req = constrain(current + delta, limitMin, limitMax);

  streamTargetJ1 = commandedAngle1;
  streamTargetJ2 = commandedAngle2;
  streamTargetJ3 = commandedAngle3;
  streamTargetJ4 = commandedAngle4;
  streamTargetJ5 = commandedAngle5;
  streamTargetJ6 = commandedAngle6;

  if      (axis == 1) streamTargetJ1 = req;
  else if (axis == 2) streamTargetJ2 = req;
  else if (axis == 3) streamTargetJ3 = req;
  else if (axis == 4) streamTargetJ4 = req;
  else if (axis == 5) streamTargetJ5 = req;
  else if (axis == 6) streamTargetJ6 = req;

  noInterrupts();
  streamMode = true;
  streamLastUpdateMs = millis();
  qHead = qTail; isMovingQueue = false; wasContinuous = false;
  interrupts();
}

void parseCommand(const char *command, float value) {
  if (estopActive) {
    if (strcmp(command, "REENABLE") != 0 && strcmp(command, "ESTOP") != 0 &&
        strcmp(command, "STATUS") != 0 && strcmp(command, "POS") != 0 &&
        strcmp(command, "CALDUMP") != 0 && strcmp(command, "VER") != 0 &&
        strncmp(command, "MODE ", 5) != 0 &&
        strncmp(command, "GET", 3) != 0) {
      Serial.println("ERR: Motion rejected - ESTOP is active. Send REENABLE first.");
      return;
    }
  }

  if (strcmp(command, "MODE T1") == 0) {
    currentOpMode = OpMode::T1_MANUAL_REDUCED;
    Serial.println("MODE: T1 (15% maximum speed)");
    sendACK();
    return;
  }
  else if (strcmp(command, "MODE AUTO") == 0) {
    currentOpMode = OpMode::AUTO;
    Serial.println("MODE: AUTO");
    sendACK();
    return;
  }
  else if (strcmp(command, "MOV") == 0) {
    // MOV command is handled in processInput; no action needed here.
    return;
  }
  else if (strcmp(command, "TCPCAL") == 0) {
    const int index = (int)value;
    if (index < 1 || index > 4 || value != (float)index) {
      Serial.println("ERR: TCPCAL <1-4>");
      return;
    }
    captureCurrentWristFrame(tcpCalPoses[index - 1]);
    Serial.print("TCPCAL: Pose "); Serial.print(index); Serial.println(" recorded");
  }
  else if (strcmp(command, "TCPCAL SOLVE") == 0) {
    for (int i = 0; i < 4; ++i) {
      if (!tcpCalPoses[i].valid) {
        Serial.println("ERR: TCPCAL needs all 4 poses");
        return;
      }
    }
    float tcp[3], rmsErrorMm;
    if (!solveTcp4Point(tcp, rmsErrorMm)) {
      Serial.println("ERR: TCPCAL singular or invalid pose set; capture more varied orientations");
      return;
    }
    toolOffset.x = tcp[0];
    toolOffset.y = tcp[1];
    toolOffset.z = tcp[2];
    scheduleEepromSave();
    Serial.print("TCPCAL: TCP X="); Serial.print(tcp[0], 3);
    Serial.print(" Y="); Serial.print(tcp[1], 3);
    Serial.print(" Z="); Serial.print(tcp[2], 3);
    Serial.print(" mm, RMS="); Serial.print(rmsErrorMm, 3);
    Serial.println(" mm (EEPROM save scheduled)");
  }
  else if (strcmp(command, "TCPCAL CLEAR") == 0) {
    for (int i = 0; i < 4; ++i) tcpCalPoses[i].valid = false;
    Serial.println("TCPCAL: 4 poses cleared");
  }
  else if (strcmp(command, "D1") == 0) {
    handleStreamJog(1, value);
  } else if (strcmp(command, "D2") == 0) {
    handleStreamJog(2, value);
  } else if (strcmp(command, "D3") == 0) {
    handleStreamJog(3, value);
  } else if (strcmp(command, "D4") == 0) {
    handleStreamJog(4, value);
  } else if (strcmp(command, "D5") == 0) {
    handleStreamJog(5, value);
  } else if (strcmp(command, "D6") == 0) {
    handleStreamJog(6, value);
  } else if (strcmp(command, "DX") == 0) {
    handleStreamJog(4, value / stepsPerDegAxis4);
  } else if (strcmp(command, "DY") == 0) {
    handleStreamJog(5, value / stepsPerDegAxis5);
  } else if (strcmp(command, "A4") == 0) {
    float v = constrain(value, LIMIT_J4_MIN, LIMIT_J4_MAX);
    moveToAngles(commandedAngle1, commandedAngle2, commandedAngle3, 1000, false, v, commandedAngle5, false, commandedAngle6);
  } else if (strcmp(command, "A5") == 0) {
    float v = constrain(value, LIMIT_J5_MIN, LIMIT_J5_MAX);
    moveToAngles(commandedAngle1, commandedAngle2, commandedAngle3, 1000, false, commandedAngle4, v, false, commandedAngle6);
  } else if (strcmp(command, "A6") == 0) {
    float v = constrain(value, LIMIT_J6_MIN, LIMIT_J6_MAX);
    moveToAngles(commandedAngle1, commandedAngle2, commandedAngle3, 1000, false, commandedAngle4, commandedAngle5, false, v);
  } else if (strcmp(command, "BACKLASH") == 0 || strncmp(command, "BACKLASH ", 9) == 0) {
    if (strncmp(command, "BACKLASH ", 9) == 0) {
      parseBacklashCommand(command + 9);
    } else {
      printBacklash();
    }
  } else if (strcmp(command, "MS") == 0) {
    if (value > 0.0f) {
      MAX_SPEED_J4 = value;
      MAX_SPEED_J5 = value;
      applySpeedOverride();
    }
  } else if (strcmp(command, "HOMEJ1") == 0) {
    startHoming(true, false, false);
  } else if (strcmp(command, "HOMEJ2") == 0) {
    startHoming(false, true, false);
  } else if (strcmp(command, "HOMEJ3") == 0) {
    startHoming(false, false, true);
  } else if (strcmp(command, "HOME") == 0) {
    startHoming(true, true, true);  // bare HOME = SWITCH (non-blocking)
  } else if (strncmp(command, "HOME ", 5) == 0) {
    const char *method = command + 5;
    while (*method == ' ') method++;
    if (strcmp(method, "SWITCH") == 0) {
      startHoming(true, true, true);  // non-blocking
    } else if (strcmp(method, "MICRO") == 0 || strcmp(method, "GANTRY") == 0) {
      homeGantry(true, true);
    } else if (strcmp(method, "ENCODER") == 0 || strcmp(method, "MANUAL") == 0) {
      // For encoder/manual, assume current position is the calibrated HOME position (0, 0, 0, 0, 0, 0)
      stepper1.setCurrentPosition(0); stepper1.moveTo(0);
      stepper2.setCurrentPosition(0); stepper2.moveTo(0);
      stepper3.setCurrentPosition(0); stepper3.moveTo(0);
      stepper4.setCurrentPosition(0); stepper4.moveTo(0);
      stepper5.setCurrentPosition(0); stepper5.moveTo(0);
      stepper6.setCurrentPosition(0); stepper6.moveTo(0);

      noInterrupts();
      commandedAngle1 = 0.0f;
      commandedAngle2 = 0.0f;
      commandedAngle3 = 0.0f;
      commandedAngle4 = 0.0f;
      commandedAngle5 = 0.0f;
      commandedAngle6 = 0.0f;
      isHomed = true;
      qHead = 0; qTail = 0; isMovingQueue = false; wasContinuous = false;
      motionLoopActive = false;
      currentVelJ1 = 0.0f; currentVelJ2 = 0.0f; currentVelJ3 = 0.0f;
      currentVelJ4 = 0.0f; currentVelJ5 = 0.0f; currentVelJ6 = 0.0f;
      currentAccJ1 = 0.0f; currentAccJ2 = 0.0f; currentAccJ3 = 0.0f;
      currentAccJ4 = 0.0f; currentAccJ5 = 0.0f; currentAccJ6 = 0.0f;
      lastSpdJ1 = 0.0f; lastSpdJ2 = 0.0f; lastSpdJ3 = 0.0f;
      lastSpdJ4 = 0.0f; lastSpdJ5 = 0.0f; lastSpdJ6 = 0.0f;
      lastAccJ1 = 0.0f; lastAccJ2 = 0.0f; lastAccJ3 = 0.0f;
      lastAccJ4 = 0.0f; lastAccJ5 = 0.0f; lastAccJ6 = 0.0f;
      for (int i = 0; i < 6; ++i) {
        backlashOffsetSteps[i] = 0.0f;
        lastDirection[i] = 0;
      }
      interrupts();

      if (strcmp(method, "ENCODER") == 0) {
        // Update encoder offsets assuming current is home
        uint16_t r1 = readAS5600(Wire2);
        if (r1 != 0xFFFF) enc1Offset = (r1 / 4096.0f) * 360.0f - commandedAngle1;
        uint16_t r2 = readAS5600(Wire);
        if (r2 != 0xFFFF) enc2Offset = (r2 / 4096.0f) * 360.0f - commandedAngle2;
        uint16_t r3 = readAS5600(Wire1);
        if (r3 != 0xFFFF) enc3Offset = (r3 / 4096.0f) * 360.0f - commandedAngle3;
      }
      applySpeedOverride();
      sendACK();
      Serial.println("HOMING: Manual/Encoder - positions set to home");
    } else {
      Serial.println("ERR: Unknown HOME method (use SWITCH, ENCODER, or MANUAL)");
    }
  } else if (strcmp(command, "CAL") == 0) {
    uint16_t r1 = readAS5600(Wire2);
    if (r1 != 0xFFFF) enc1Offset = (r1 / 4096.0f) * 360.0f - commandedAngle1;
    uint16_t r2 = readAS5600(Wire);
    if (r2 != 0xFFFF) enc2Offset = (r2 / 4096.0f) * 360.0f - commandedAngle2;
    uint16_t r3 = readAS5600(Wire1);
    if (r3 != 0xFFFF) enc3Offset = (r3 / 4096.0f) * 360.0f - commandedAngle3;

    Serial.println("CALIBRATED: Encoder Offsets synced to current commanded angles");
  } else if (strcmp(command, "DIAG") == 0) {
    Serial.println("\n=== DIAGNOSTICS ===");
    printDriver("Axis 1", driver1);
    printDriver("Axis 2", driver2);
    printDriver("Axis 3", driver3);
  } else if (strcmp(command, "ENC") == 0) {
    Serial.println("\n=== ENCODER POSITIONS ===");
    Serial.print("Encoder 1 (Base):     ");
    if (encEnabled[0]) Serial.println(readAS5600(Wire2)); else Serial.println("DISABLED");
    Serial.print("Encoder 2 (Shoulder): ");
    if (encEnabled[1]) Serial.println(readAS5600(Wire)); else Serial.println("DISABLED");
    Serial.print("Encoder 3 (Elbow):    ");
    if (encEnabled[2]) Serial.println(readAS5600(Wire1)); else Serial.println("DISABLED");
  } else if (strcmp(command, "CL_ON") == 0) {
    useEncoders = true;
    manualCL = true;
    wasContinuous = false;
    Serial.println("Closed Loop: ENABLED (manual)");
  } else if (strcmp(command, "CL_OFF") == 0) {
    if (streamMode) stopStreamMode(false);
    noInterrupts();
    qHead = qTail;
    isMovingQueue = false;
    wasContinuous = false;
    currentVelJ1 = 0.0f; currentVelJ2 = 0.0f; currentVelJ3 = 0.0f;
    currentAccJ1 = 0.0f; currentAccJ2 = 0.0f; currentAccJ3 = 0.0f;
    lastSpdJ1 = 0.0f; lastSpdJ2 = 0.0f; lastSpdJ3 = 0.0f;
    lastAccJ1 = 0.0f; lastAccJ2 = 0.0f; lastAccJ3 = 0.0f;
    syncCommandedToStepperPosition();
    pidAdj1 = 0.0f;
    pidAdj2 = 0.0f;
    pidAdj3 = 0.0f;
    useEncoders = false;
    manualCL = false;
    interrupts();
    Serial.println("Closed Loop: DISABLED");
  } else if (strcmp(command, "ENC1") == 0) {
    encEnabled[0] = (value != 0.0f);
    Serial.print("Encoder 1: ");
    Serial.println(encEnabled[0] ? "ENABLED" : "DISABLED");
  } else if (strcmp(command, "ENC2") == 0) {
    encEnabled[1] = (value != 0.0f);
    Serial.print("Encoder 2: ");
    Serial.println(encEnabled[1] ? "ENABLED" : "DISABLED");
  } else if (strcmp(command, "ENC3") == 0) {
    encEnabled[2] = (value != 0.0f);
    Serial.print("Encoder 3: ");
    Serial.println(encEnabled[2] ? "ENABLED" : "DISABLED");
  } else if (strcmp(command, "JNT1") == 0) {
    jointEnabled[0] = (value != 0.0f);
    Serial.print("Joint 1: ");
    Serial.println(jointEnabled[0] ? "ENABLED" : "DISABLED");
  } else if (strcmp(command, "JNT2") == 0) {
    jointEnabled[1] = (value != 0.0f);
    Serial.print("Joint 2: ");
    Serial.println(jointEnabled[1] ? "ENABLED" : "DISABLED");
  } else if (strcmp(command, "JNT3") == 0) {
    jointEnabled[2] = (value != 0.0f);
    Serial.print("Joint 3: ");
    Serial.println(jointEnabled[2] ? "ENABLED" : "DISABLED");
  } else if (strcmp(command, "JNT4") == 0) {
    jointEnabled[3] = (value != 0.0f);
    Serial.print("Joint 4: ");
    Serial.println(jointEnabled[3] ? "ENABLED" : "DISABLED");
  } else if (strcmp(command, "JNT5") == 0) {
    jointEnabled[4] = (value != 0.0f);
    Serial.print("Joint 5: ");
    Serial.println(jointEnabled[4] ? "ENABLED" : "DISABLED");
  } else if (strcmp(command, "JNT6") == 0) {
    jointEnabled[5] = (value != 0.0f);
    Serial.print("Joint 6: ");
    Serial.println(jointEnabled[5] ? "ENABLED" : "DISABLED");
  } else if (strcmp(command, "GEAR1") == 0) {
    if (value <= 0.0f) {
      Serial.println("ERR: Gear ratio must be > 0");
      return;
    }
    gearboxRatioAxis1 = value;
    stepsPerDegAxis1 = (STEPS_PER_MOTOR_REV * gearboxRatioAxis1) / 360.0f;
    Serial.print("Gearbox Ratio Axis 1: ");
    Serial.println(gearboxRatioAxis1, 2);
  } else if (strcmp(command, "GEAR2") == 0) {
    if (value <= 0.0f) {
      Serial.println("ERR: Gear ratio must be > 0");
      return;
    }
    gearboxRatio = value;
    stepsPerDegGeared = (STEPS_PER_MOTOR_REV * gearboxRatio) / 360.0f;
    Serial.print("Gearbox Ratio Axis 2/3: ");
    Serial.println(gearboxRatio, 2);
  } else if (strcmp(command, "TELEM") == 0) {
    useTelemetry = (value != 0.0f);
    Serial.print("Telemetry: ");
    Serial.println(useTelemetry ? "ENABLED" : "DISABLED");
  } else if (strcmp(command, "REENABLE") == 0) {
    // Resynchronize commanded positions and clear PID filters before re-energizing drivers
    syncCommandedToStepperPosition();
    noInterrupts();
    pid1.integral = 0; pid1.lastError = 0;
    pid2.integral = 0; pid2.lastError = 0;
    pid3.integral = 0; pid3.lastError = 0;
    pidAdj1 = 0.0f; pidAdj2 = 0.0f; pidAdj3 = 0.0f;
    lastSpdJ1 = 0.0f; lastSpdJ2 = 0.0f; lastSpdJ3 = 0.0f;
    lastAccJ1 = 0.0f; lastAccJ2 = 0.0f; lastAccJ3 = 0.0f;
    wasContinuous = false;
    estopActive = false;
    interrupts();

    digitalWrite(PIN_AXIS1_EN, LOW);
    digitalWrite(PIN_AXIS2_EN, LOW);
    digitalWrite(PIN_AXIS3_EN, LOW);
    digitalWrite(PIN_WRIST_EN, LOW);
    applyHoldCurrent();
    if (useEncoders && cachedEncoderValid) {
      refreshEncoderCache();
      commandedAngle1 = cachedEncAngle1;
      commandedAngle2 = cachedEncAngle2;
      commandedAngle3 = cachedEncAngle3;
      stepper1.setCurrentPosition((long)roundf(commandedAngle1 * stepsPerDegAxis1));
      stepper2.setCurrentPosition((long)roundf(commandedAngle2 * stepsPerDegGeared));
      stepper3.setCurrentPosition(j3AngleToSteps(commandedAngle3));
      isHomed = true;
      Serial.println("Positions resynchronized from absolute encoders.");
    } else {
      isHomed = false;
      Serial.println("WARN: Re-homing recommended after ESTOP.");
    }
    Serial.println("Drivers re-enabled");
  } else if (strcmp(command, "ESTOP") == 0) {
    noInterrupts();
    estopActive = true;
    controlledStopReq = false;
    rampScale = 1.0f;
    calTestActive = false;
    setStepperSpeedDDA(0, stepper1, 0.0f);
    setStepperSpeedDDA(1, stepper2, 0.0f);
    setStepperSpeedDDA(2, stepper3, 0.0f);
    setStepperSpeedDDA(3, stepper4, 0.0f);
    setStepperSpeedDDA(4, stepper5, 0.0f);
    setStepperSpeedDDA(5, stepper6, 0.0f);
    interrupts();
    // EMERGENCY STOP: Halt all motion immediately
    if (streamMode) stopStreamMode(false);
    stepper1.stop();
    stepper2.stop();
    stepper3.stop();
    stepper4.stop();
    stepper5.stop();
    stepper6.stop();

    // Physically disable drivers (release holding torque)
    digitalWrite(PIN_AXIS1_EN, HIGH);
    digitalWrite(PIN_AXIS2_EN, HIGH);
    digitalWrite(PIN_AXIS3_EN, HIGH);
    digitalWrite(PIN_WRIST_EN, HIGH);
    digitalWrite(PIN_MICRO_EN, HIGH);
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
