adammotyl22-creator/STPPE-Reborn/(commit log)

2026-10-12 Initial project import
    [Base_1.3mf, Bryła12.3mf, Złożenie 1.5.step, base_link.stl, link_1.stl, link_2.stl, link_3.stl, link_4.stl]
2026-10-12 Remove Teensy pinout
2026-10-12 Remove models and graphics assets
    [Base_1.3mf, Bryła12.3mf, Złożenie 1.5.step]
2026-10-12 Use robot assembly and cutaway artwork for README banner
2026-10-21 feat(control-studio): industrial CAD visual overhaul, 6-DOF Euler orientation, wrist presets, and comprehensive Polish localization
    - Upgrade Control Studio with soft neutral precision CAD styling, bevel tokens, and 100vh zero-scroll layout
    - Add vernier scale dual-markers (live vs ghost) and animated SVG gripper jaw indicator
    - Enhance Three.js viewport with calibrated studio lighting, PBR materials, polar CAD grid, and 2D-3D joint hover highlighting
    - Implement 6-DOF Euler orientation with orbital yaw tracking, 7 wrist presets (W0-W6), and J5 limit alignment (-120°..+120°)
    - Overhaul bilingual English/Polish localization across UI and documentation with natural industrial robotics termin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
    [stppe_zlozenie_nowe.urdf]
